bvenneker/Chat64/ZXSpectrum/KiCAD/voltage regulator.jpg

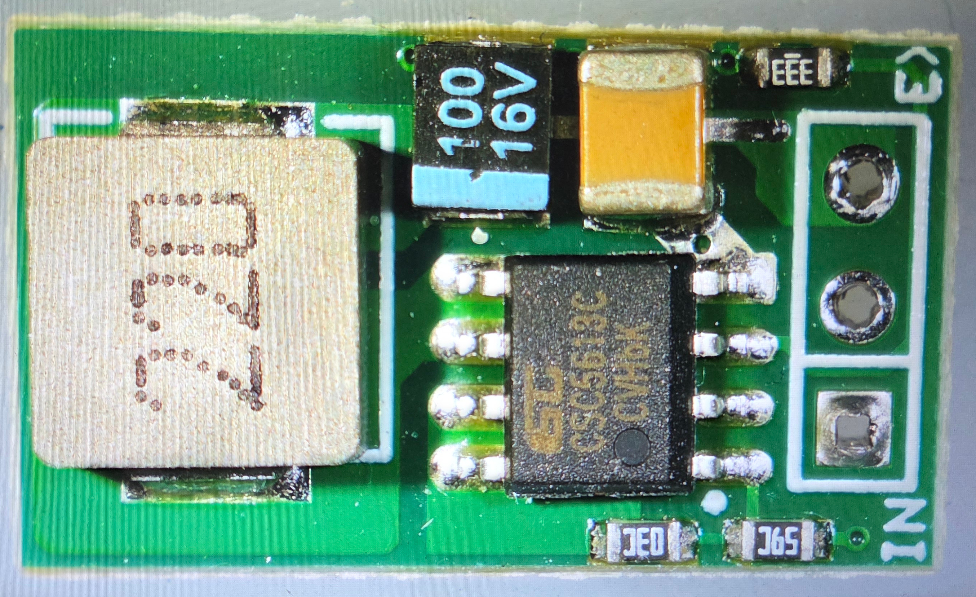
ZXSpectrum/KiCAD/voltage regulator.jpg
