bvenneker/Chat64/README.md

# CHAT64_C64
Chat64 for Commodore64, Sinclair ZX Spectrum, Atari 800XL, MSX and Amstrad CPC.
