bvenneker/Chat64/AmstradCPC/cartridge_model/readme.txt

I print the cartridge shells in PLA. I print the reset button in transparant PETG

extra hardware for the cartridge enclosure.

4 x m2 threaded inserts
4 x m2 screws (about 16 mm)
