bvenneker/Chat64/Atari800XL/cartridge_model/readme.txt

I print the cartridge shells in PLA. I print the reset button in transparant PETG

extra hardware for the cartridge enclosure.

1 x m3 threaded inserts
1 x m3 screw (16 mm)
