bvenneker/Chat64/MSX/cartridge_model/readme.txt

I print the cartridge shells in PLA. I print the reset button in transparant PETG

extra hardware for the cartridge enclosure.

3 x m2 threaded inserts
3 x m2 screws (about 16 mm)
