bvenneker/Chat64/ZXSpectrum/KiCAD/Readme.txt

Only the old THT version contains a GAL chip.
The old THT version DOES NOT WORK on a spectrum 128 +2b (the black one) and higher

The newer SMD version does not contain a GAL chip.
The SMD version works on the Spectrum 48k and better, including the +2b and up, made by Amstrad

Voltage regulator:
The pcb contains a 5v voltage regulator module (I get them from Aliexpress), see pictures
The ones I buy on Aliexpress have 3 pin connector on them, I remove that.
TIP: TEST the regulator before you install it. They should have about 5 volts (4.8 - 5.2) on the output but I have seen some that had the input voltage on the output.
