bvenneker/Chat64/ZXSpectrum/cartridge_model/Readme.txt

Version 1 THT (through hole technology)
The THT cartridge model needs:
3 x m2 Threaded Insert 
1 x m3 Threaded Insert 
3 x m2 screw (10mm)
1 x M3 screw (16mm)
