bvenneker/Chat64/ZXSpectrum/cartridge_model/labels.pdf

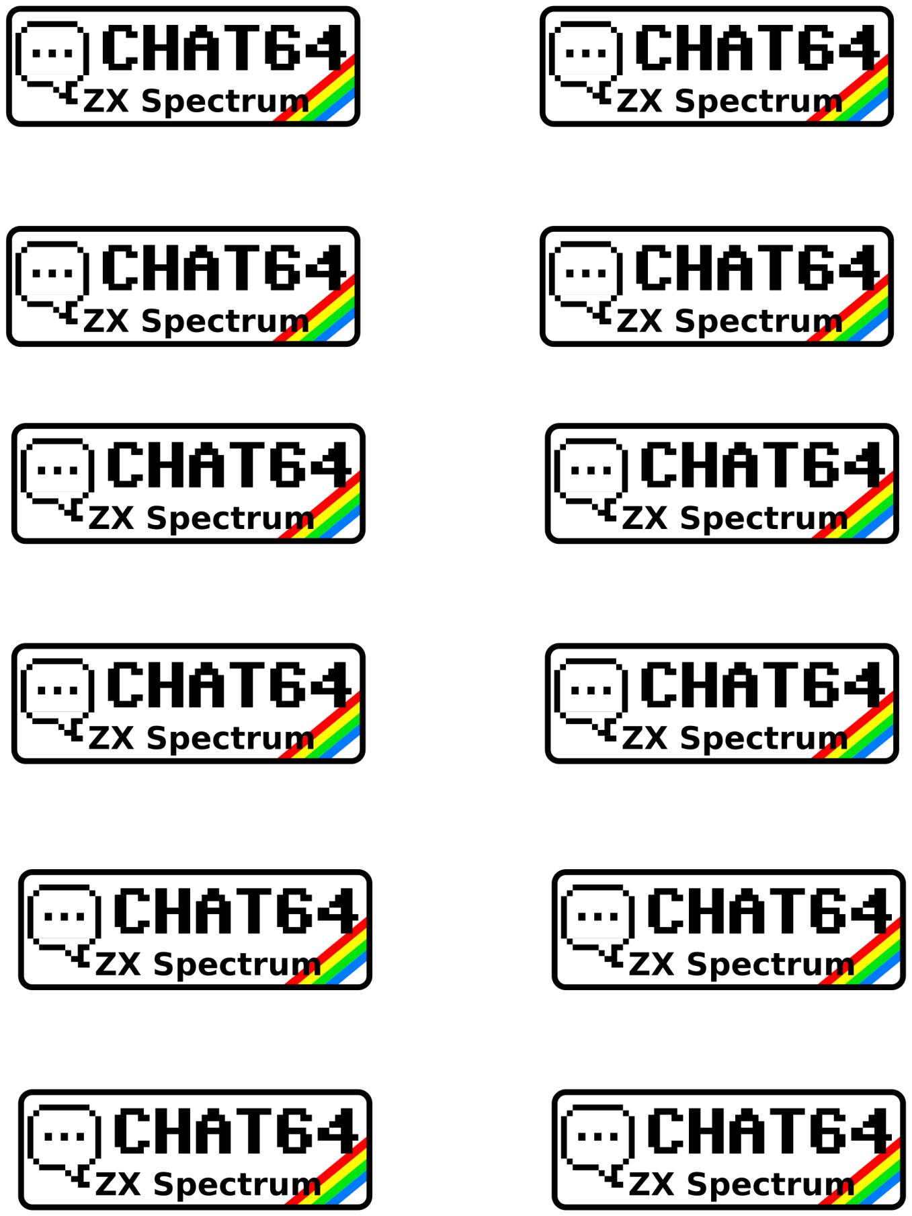
[picture p3: page 1]
