bvenneker/Chat64/AmstradCPC/cartridge_model/labels.pdf

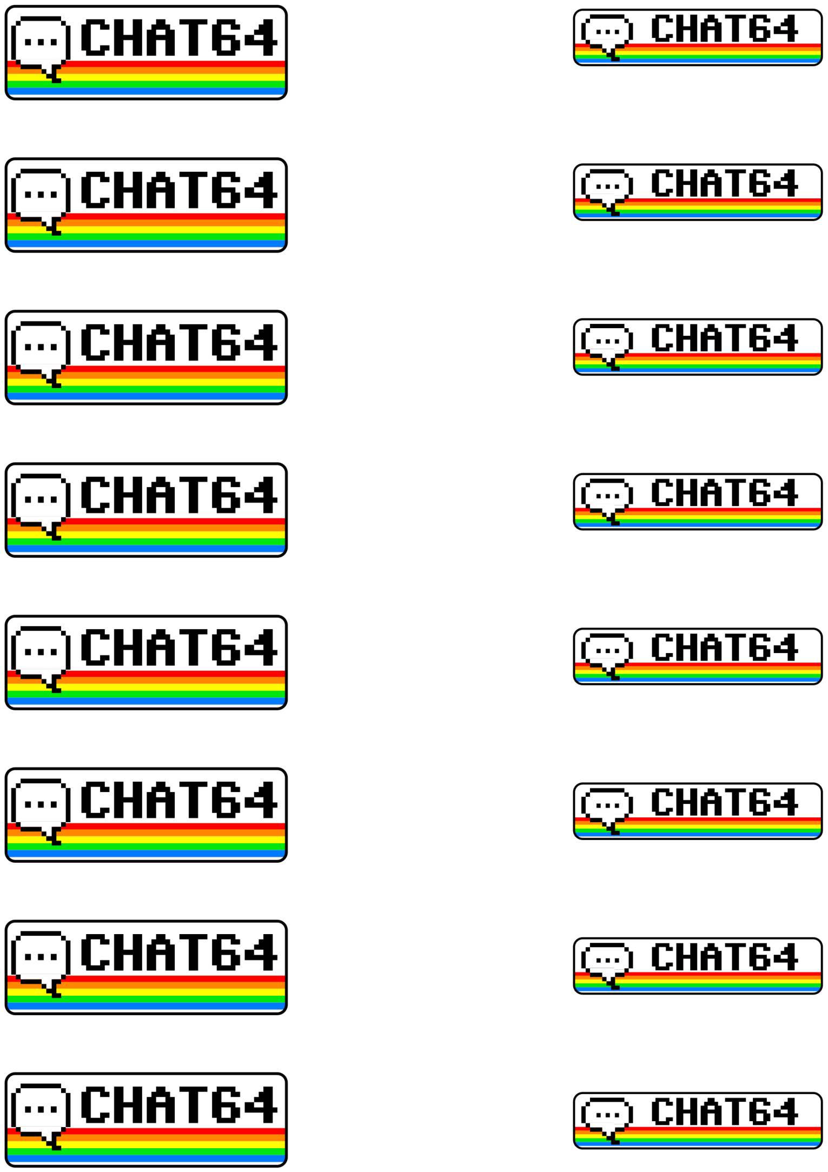
[picture p4: page 1]
