bvenneker/Chat64/AmstradCPC/cartridge_model/20260906_133205.jpg

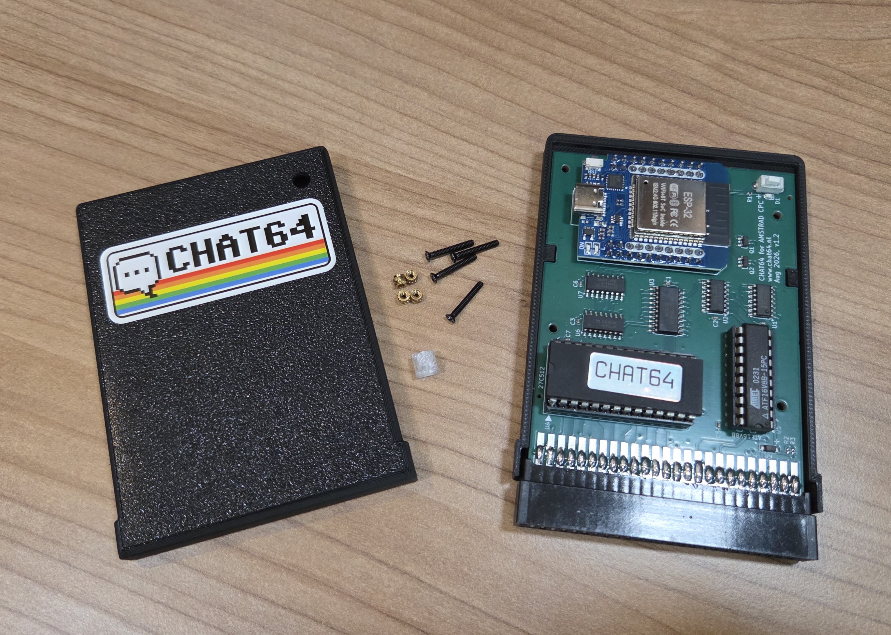
AmstradCPC/cartridge_model/20260906_133205.jpg
