bvenneker/Chat64/AmstradCPC/cartridge_model/20260906_134645.jpg

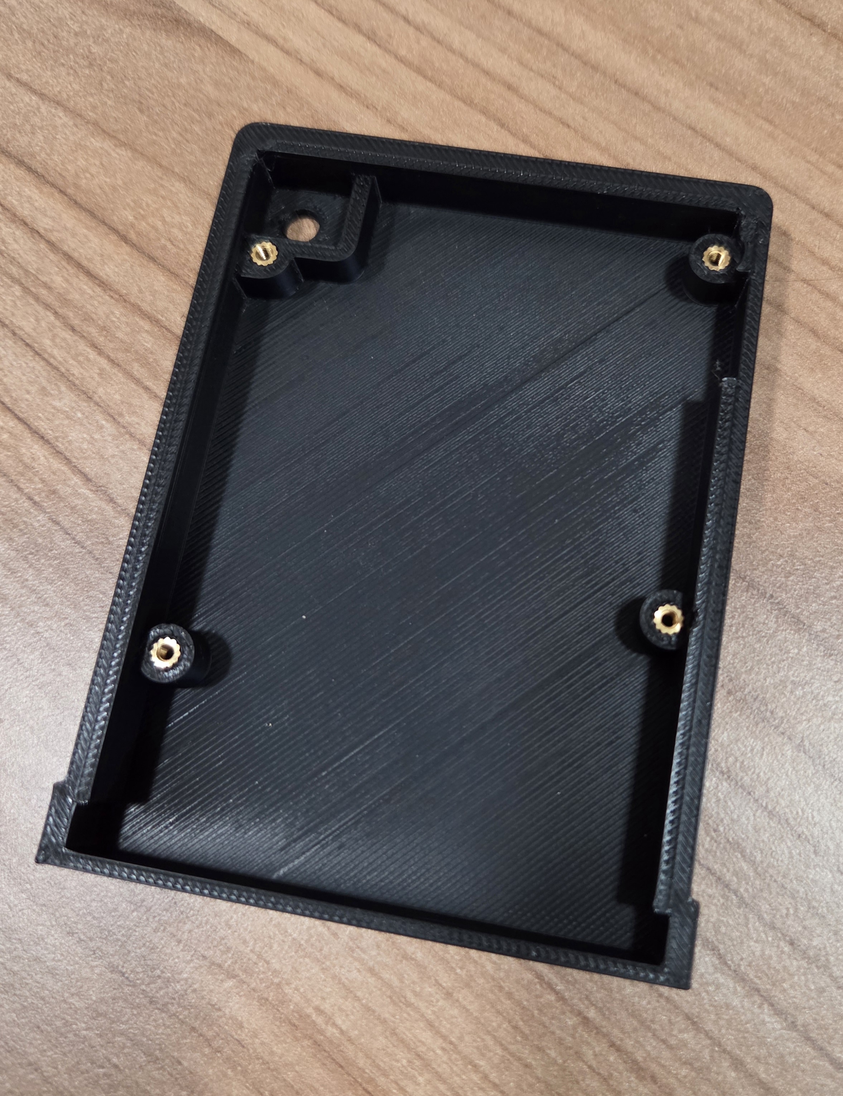
AmstradCPC/cartridge_model/20260906_134645.jpg
