bvenneker/Chat64/ZXSpectrum/cartridge_model/THT_20260906_115402.jpg

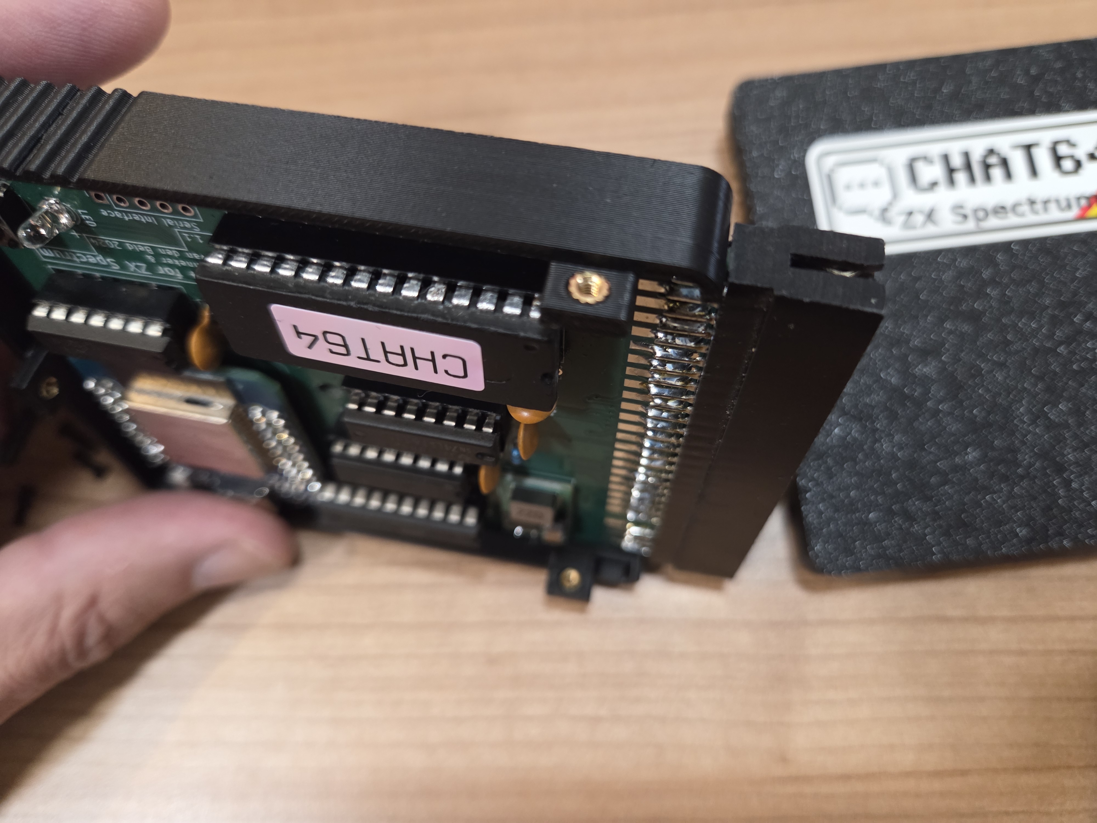
ZXSpectrum/cartridge_model/THT_20260906_115402.jpg
