bvenneker/Chat64/ZXSpectrum/KiCAD/voltage regulator_aliexpress.jpg

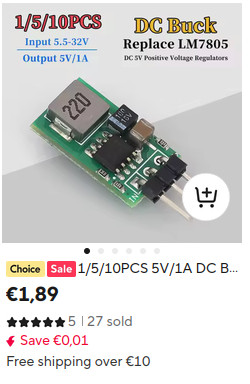
ZXSpectrum/KiCAD/voltage regulator_aliexpress.jpg
