bvenneker/Chat64/AmstradCPC/cartridge_model/CPC Cartridge Top Shell.stl

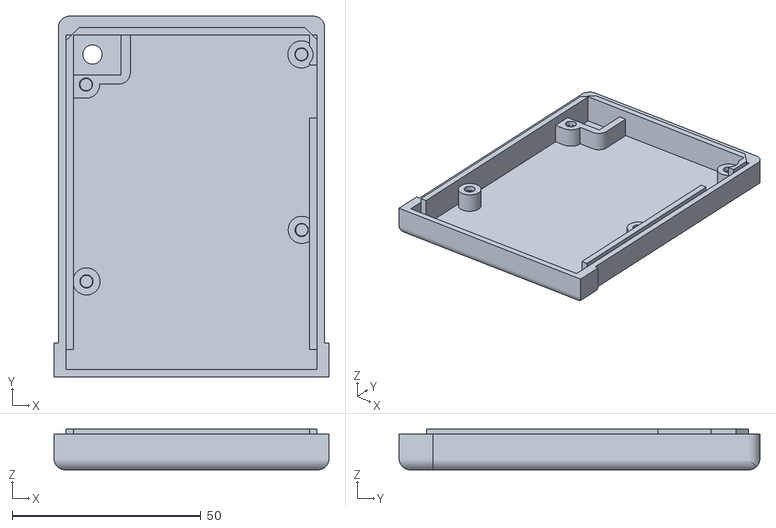
[picture p11: CAD file, 2026-09-07]
AmstradCPC/cartridge_model/CPC Cartridge Top Shell.stl
72.8 x 95.5 x 10.8
