bvenneker/Chat64/Atari800XL/cartridge_model/Atari_Chat_Cartridge_Button.stl

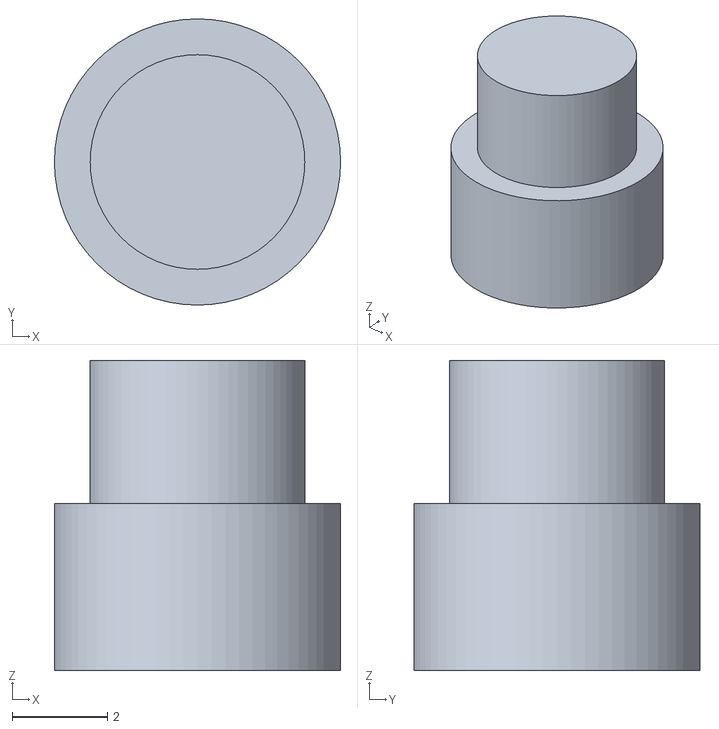
[picture p12: CAD file, 2026-09-07]
Atari800XL/cartridge_model/Atari_Chat_Cartridge_Button.stl
6.00 x 6.00 x 6.50
