bvenneker/Chat64/Commodore/cartridge_model/SMD Model/Chat64 SMD cartridge.3mf

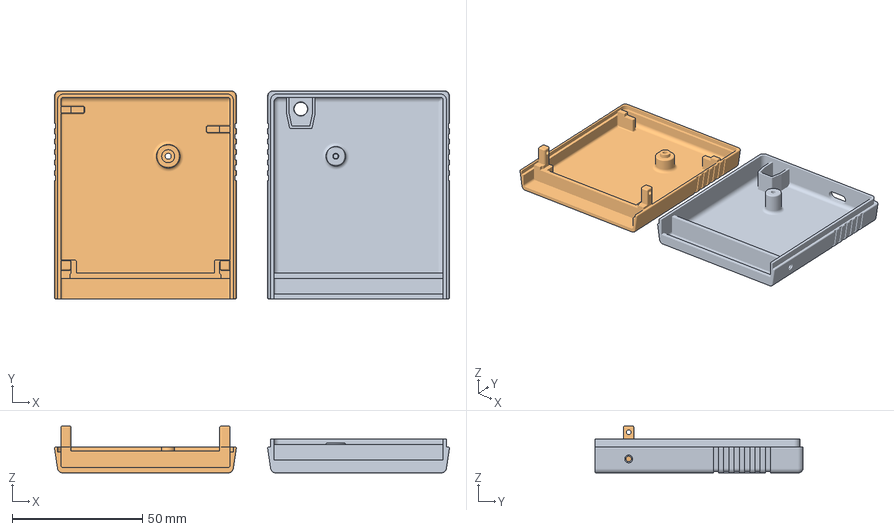
[picture p13: CAD file, 2026-09-05]
Commodore/cartridge_model/SMD Model/Chat64 SMD cartridge.3mf
151.7 x 80.0 x 18.0 mm
Upper
Lower
