bvenneker/Chat64/Commodore/cartridge_model/SMD Model/SMD-STL/Smd-lower.stl

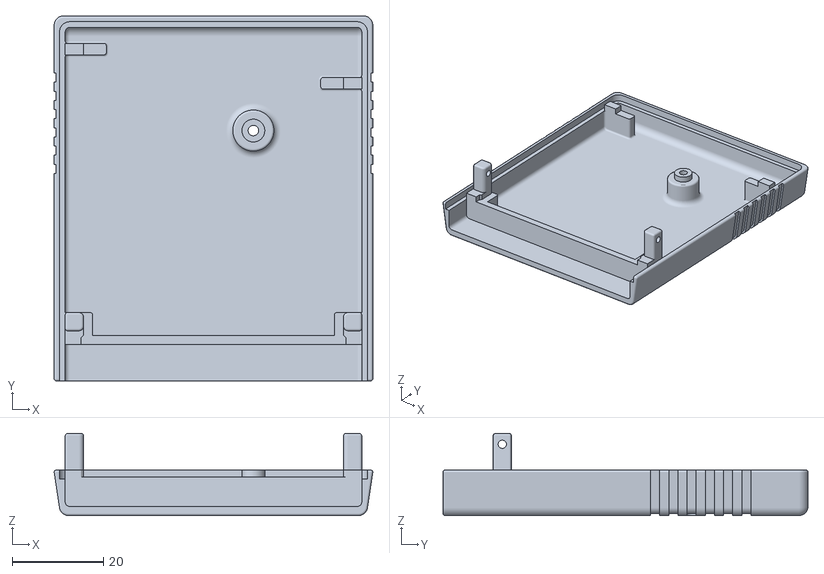
[picture p14: CAD file, 2026-09-05]
Commodore/cartridge_model/SMD Model/SMD-STL/Smd-lower.stl
69.8 x 80.0 x 18.0
