bvenneker/Chat64/Commodore/cartridge_model/THT Model/THT_model2025.stl

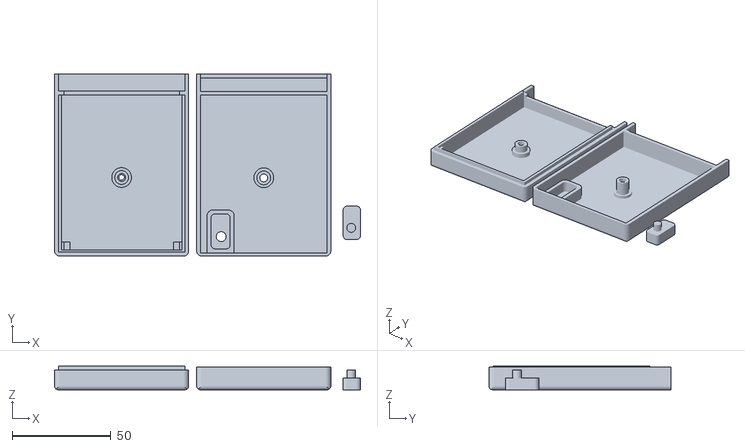
[picture p15: CAD file, 2026-09-05]
Commodore/cartridge_model/THT Model/THT_model2025.stl
155.0 x 92.3 x 12.0
