bvenneker/Chat64/MSX/cartridge_model/MSX Cartridge_Top.stl

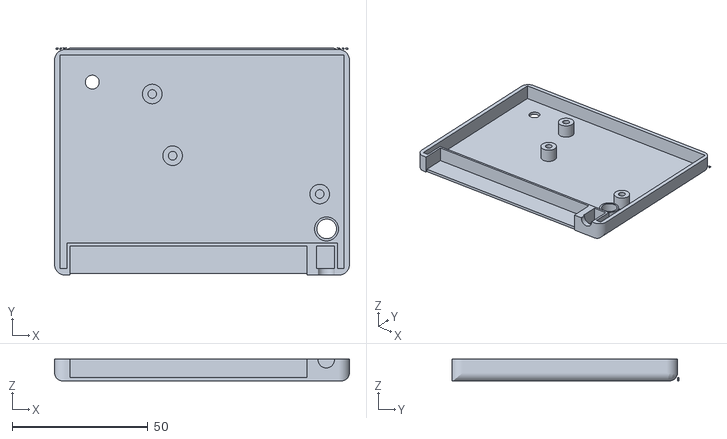
[picture p16: CAD file, 2026-09-07]
MSX/cartridge_model/MSX Cartridge_Top.stl
108.5 x 83.6 x 8.00
