bvenneker/Chat64/ZXSpectrum/cartridge_model/THT_Shell_Top.stl

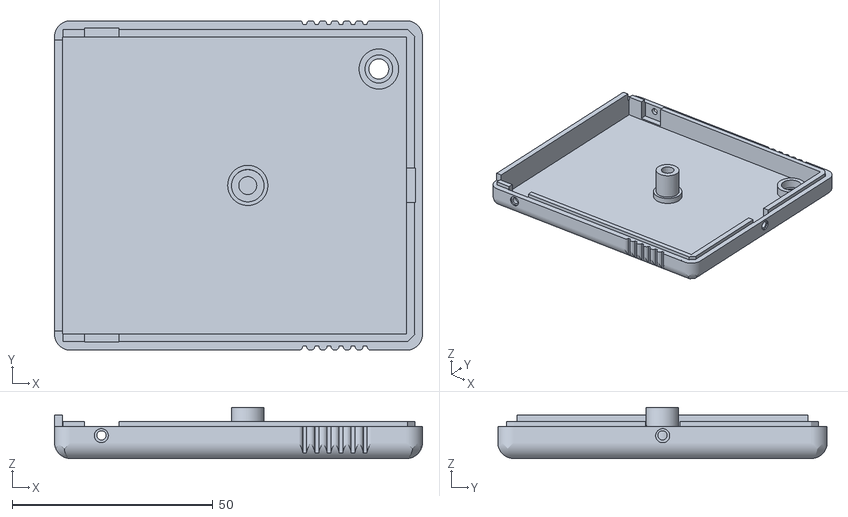
[picture p17: CAD file, 2026-09-06]
ZXSpectrum/cartridge_model/THT_Shell_Top.stl
91.6 x 82.0 x 12.7
