bvenneker/Chat64/AmstradCPC/cartridge_model/CPC Cartridge Bottom Shell.stl

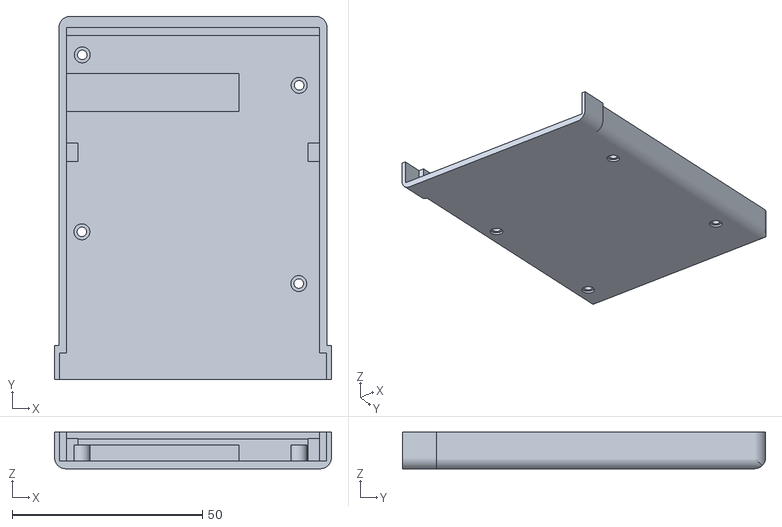
[picture p18: CAD file, 2026-09-07]
AmstradCPC/cartridge_model/CPC Cartridge Bottom Shell.stl
72.8 x 95.5 x 9.60
