bvenneker/Chat64/Atari800XL/cartridge_model/Atari_Chat_Cartridge_Top.stl

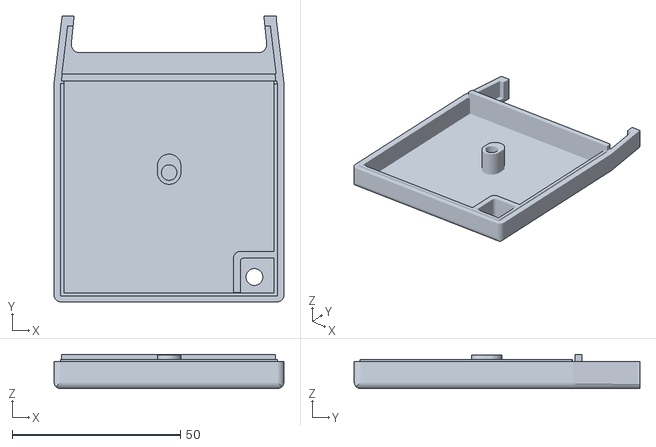
[picture p19: CAD file, 2026-09-07]
Atari800XL/cartridge_model/Atari_Chat_Cartridge_Top.stl
68.4 x 85.0 x 10.2
