bvenneker/Chat64/Commodore/cartridge_model/SMD Model/Cartridge knobs.3mf

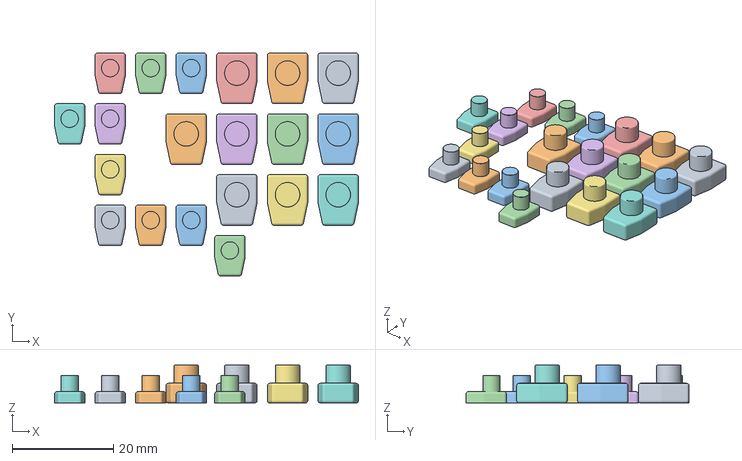
[picture p20: CAD file, 2026-09-05]
Commodore/cartridge_model/SMD Model/Cartridge knobs.3mf
60.0 x 44.0 x 7.50 mm
Knob x 10
Knob_hollow_trans_inner x 10
