bvenneker/Chat64/Commodore/cartridge_model/SMD Model/SMD-STL/Smd-knob_short.stl

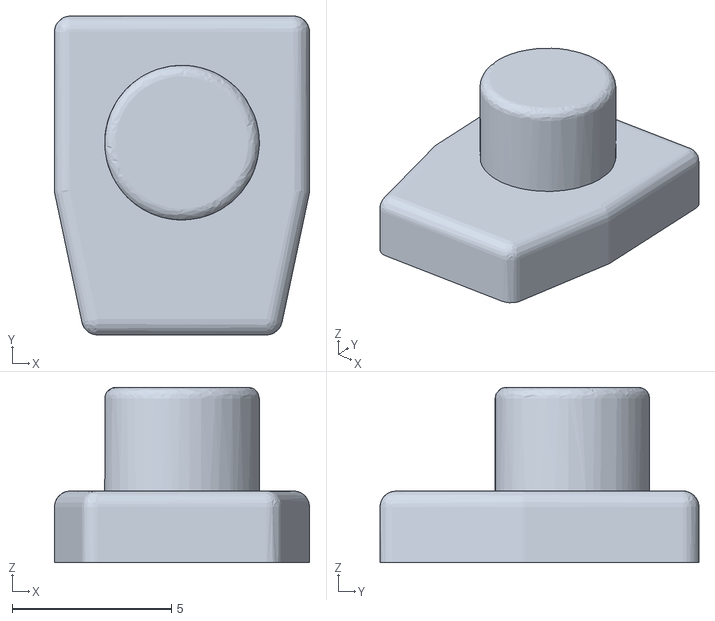
[picture p21: CAD file, 2026-09-05]
Commodore/cartridge_model/SMD Model/SMD-STL/Smd-knob_short.stl
8.00 x 10.0 x 5.50
