bvenneker/Chat64/MSX/cartridge_model/MSX Cartridge_Button.stl

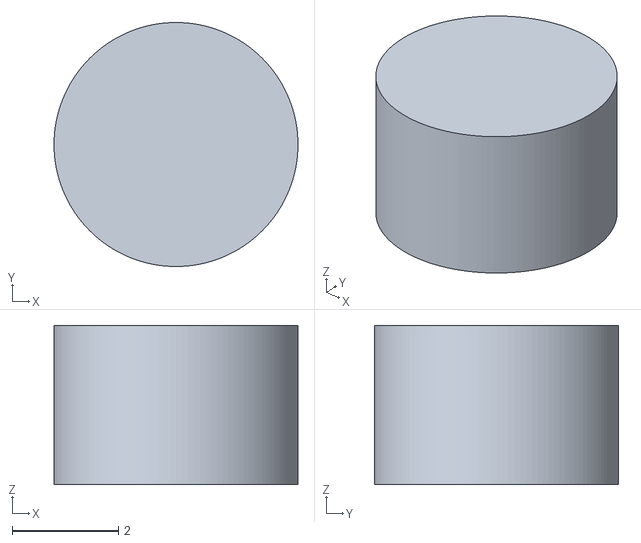
[picture p22: CAD file, 2026-09-07]
MSX/cartridge_model/MSX Cartridge_Button.stl
4.60 x 4.60 x 3.00
