bvenneker/Chat64/ZXSpectrum/cartridge_model/SMD_Shell_Bottom.stl

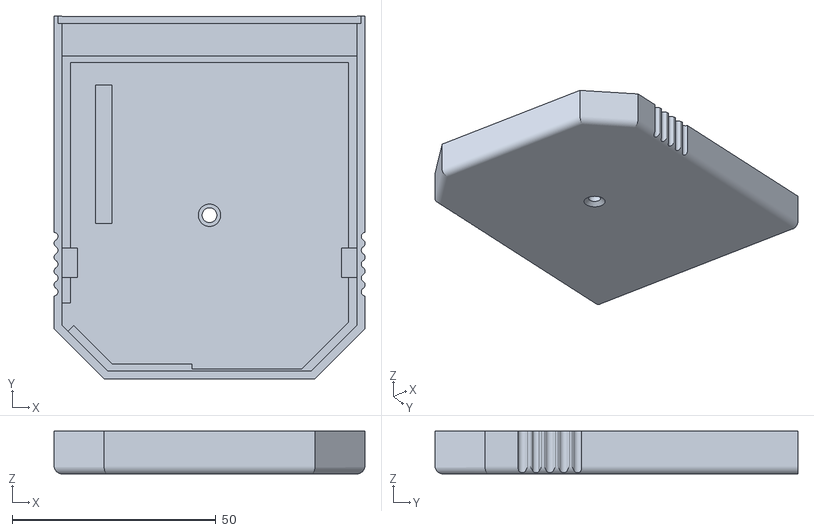
[picture p23: CAD file, 2026-09-06]
ZXSpectrum/cartridge_model/SMD_Shell_Bottom.stl
76.3 x 89.1 x 10.5
