bvenneker/Chat64/AmstradCPC/cartridge_model/CPC Cartridge Button.stl

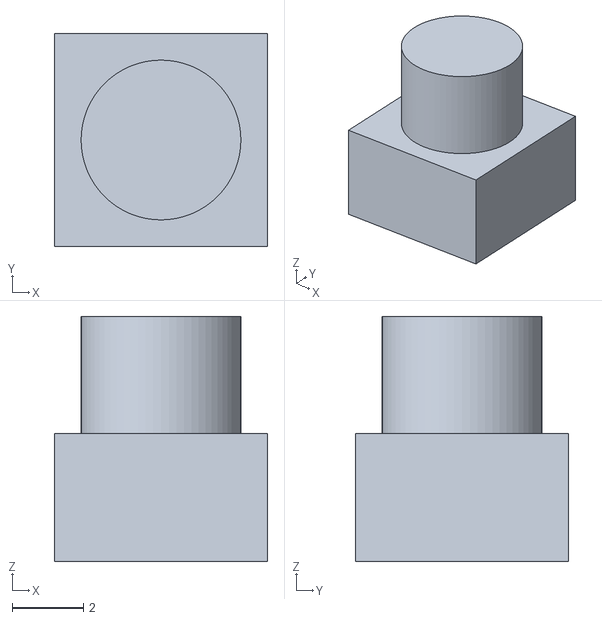
[picture p24: CAD file, 2026-09-07]
AmstradCPC/cartridge_model/CPC Cartridge Button.stl
6.00 x 6.00 x 6.90
