bvenneker/Chat64/Commodore/cartridge_model/SMD Model/SMD-STL/Smd-knob.stl

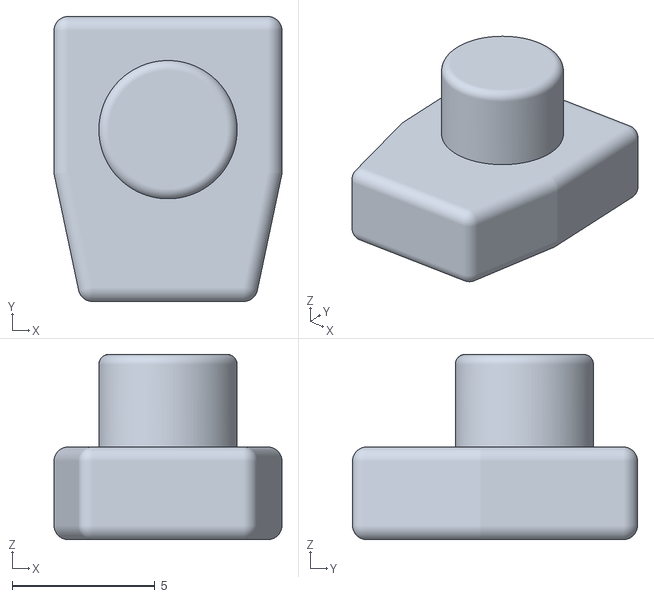
[picture p26: CAD file, 2026-09-05]
Commodore/cartridge_model/SMD Model/SMD-STL/Smd-knob.stl
8.00 x 10.0 x 6.50
