bvenneker/Chat64/MSX/cartridge_model/MSX Cartridge_Bottom.stl

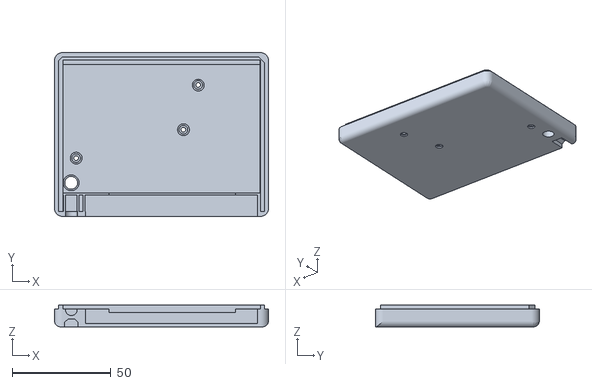
[picture p27: CAD file, 2026-09-07]
MSX/cartridge_model/MSX Cartridge_Bottom.stl
108.5 x 83.0 x 11.0
