bvenneker/Chat64/ZXSpectrum/cartridge_model/SMD_Shell_Top.stl

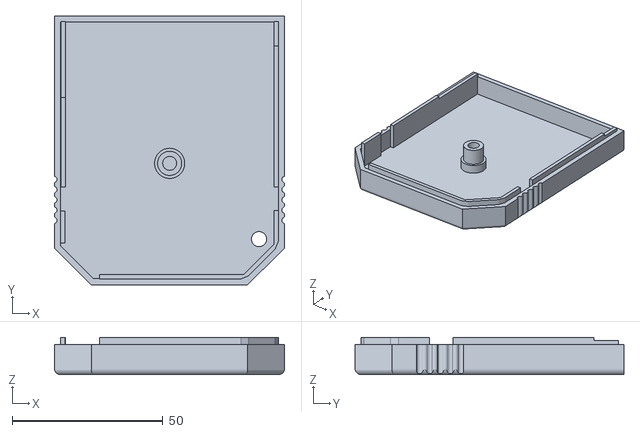
[picture p28: CAD file, 2026-09-06]
ZXSpectrum/cartridge_model/SMD_Shell_Top.stl
76.3 x 89.1 x 12.3
