bvenneker/Chat64/Commodore/cartridge_model/SMD Model/SMD-STL/Smd-upper.stl

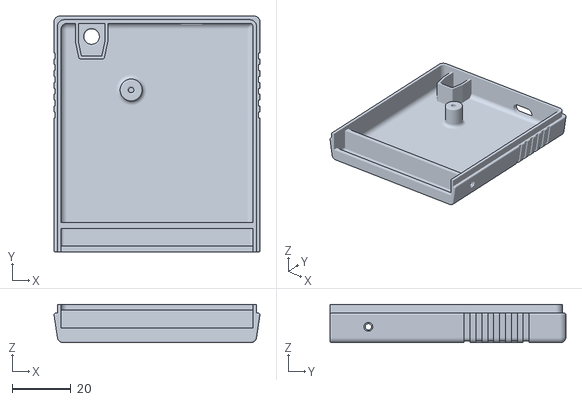
[picture p29: CAD file, 2026-09-05]
Commodore/cartridge_model/SMD Model/SMD-STL/Smd-upper.stl
69.8 x 80.0 x 13.0
