bvenneker/Chat64/ZXSpectrum/cartridge_model/SMD_Button.stl

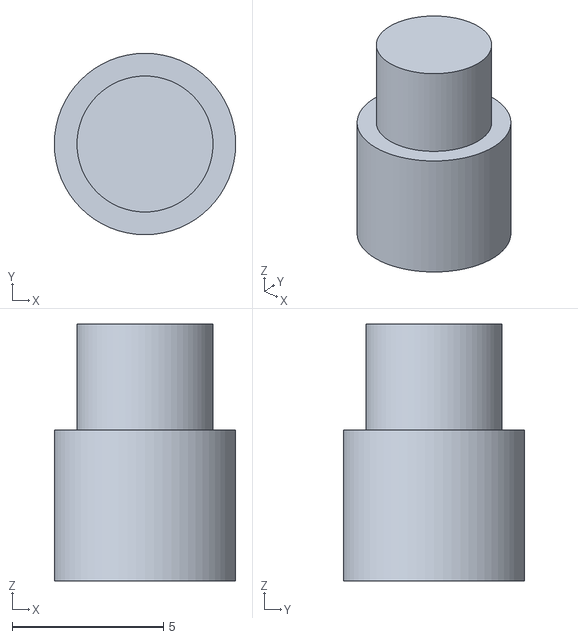
[picture p30: CAD file, 2026-09-06]
ZXSpectrum/cartridge_model/SMD_Button.stl
6.00 x 6.00 x 8.50
