bvenneker/Chat64/ZXSpectrum/cartridge_model/THT_Shell_Bottom.stl

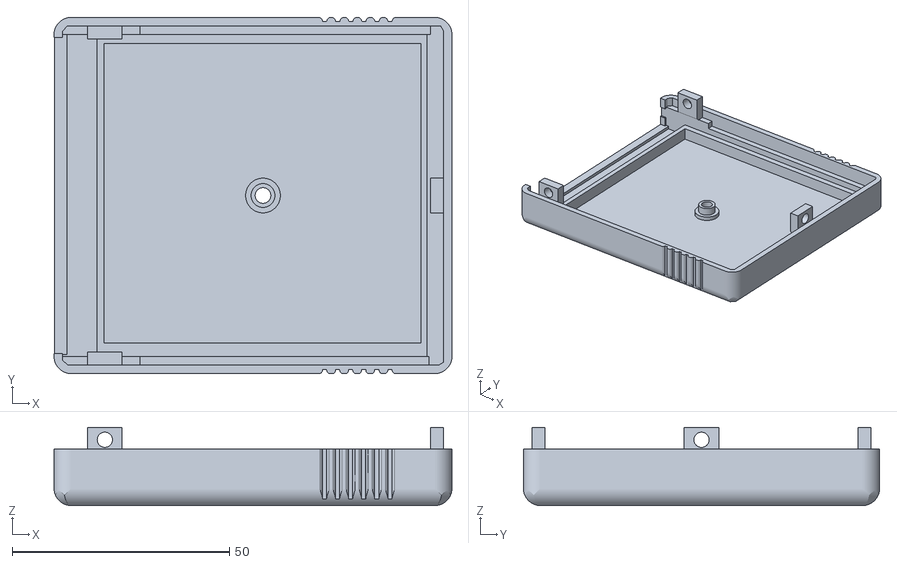
[picture p31: CAD file, 2026-09-06]
ZXSpectrum/cartridge_model/THT_Shell_Bottom.stl
91.6 x 82.0 x 18.0
