bvenneker/Chat64/ZXSpectrum/cartridge_model/THT_Button.stl

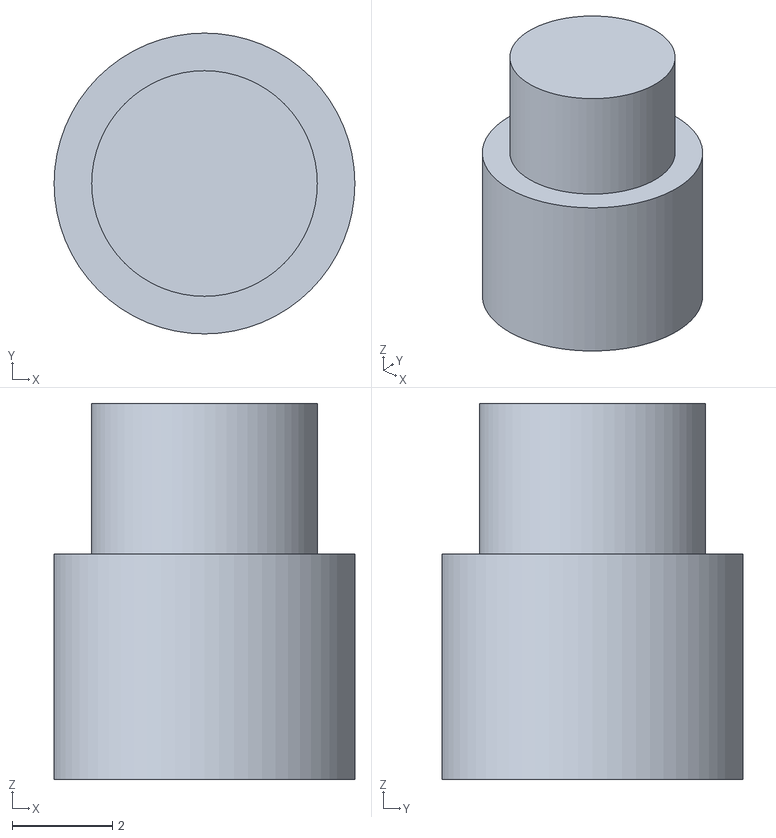
[picture p32: CAD file, 2026-09-06]
ZXSpectrum/cartridge_model/THT_Button.stl
6.00 x 6.00 x 7.50
