bvenneker/Chat64/ZXSpectrum/cartridge_model/Wedge.stl

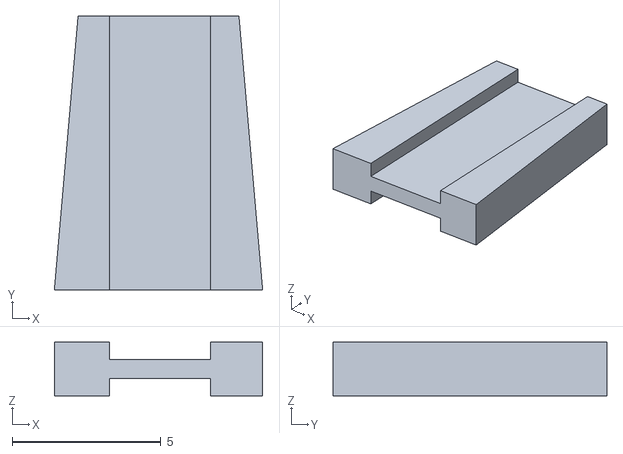
[picture p33: CAD file, 2026-09-06]
ZXSpectrum/cartridge_model/Wedge.stl
7.00 x 9.20 x 1.80
