bvenneker/Chat64/(threads)

Thread 1 (2024-02-17):

Can't wait to order a Chat64 kit!!!

Paulie420, 2024-02-17:
Thru-Hole, of course. - let us know where we can go.....

SvenPook, 2024-02-22:
An issue has been found, making the cartridges incompatible with some Commodore 64 board revisions. We want to fix this first to make sure every cartridge will work fine with any revision mainboard. Please bear with us, a new revision will be available soon.

SvenPook, 2024-02-22:
see comment above

bvenneker, 2024-04-02:
See: https://www.etsy.com/shop/bartselektronica

Closed 2024-02-22.

Thread 2 (2024-02-25):

Are the old Gerbers usable?

vk5ln, 2024-02-25:
Looks like I did a JLCPCB order too soon. I sent off the Chat64 SMD gerbers to JLCPCB last week, I've just had an email to say my order is on it's way to me.

I now see that the files have been removed due to an issue? Will my PCBs be useless? I used the production Gerber files.

SvenPook, 2024-02-25:
My old cartridge is still working, so that shouldn't be an issue.
Chances are that your cartridge might be incompatible with your Commodore 64's mainboard revision.

vk5ln, 2024-02-25:
Thank you for the reply.

bvenneker, 2024-02-25:
No, please wait a few days for the new design. We will upload them to
github when we have received the proto PCBs and tested them.

Best,
Bart

Op zo 25 feb. 2024 20:57 schreef vk5ln ***@***.***>:

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

vk5ln, 2024-02-26:
Too late :-) already have blank Chat64 SMD PCBs on the way. Oh well, they can join my pile of unused boards :-D

Crouze, 2024-02-26:
I understand the frustration of finding an error on your board design after going public with it, and having to re-design and re-test. However, a little bit more openness would be appreciated. I too already have PCB's on their way of the retracted THT design. Not a big investment, but still. The questions I now have are simple:

 - which C64 mainboard revisions were found to be incompatible with your PCB design? Which are known to work?
 - can the retracted PCB be modified (with cut traces and bodge wires) to the new design, at least in theory?

 Thanks.

bvenneker, 2024-02-27:
There is no error in the 'old' design. It works good on many C64s. Especially the newer C64-C. You may run into issues on older models. Then again, I think we have tested successfully on every revision including some very early ones.
It also works great on the Ultimate 64 model. But forget about the C64 sx :-)

We expect the prototype pcb's at the end of this week, we will publish the new design as soon as we have tested them.

Crouze, 2024-02-27:
Good to hear. Then I will populate my PCB which should also arrive at the end of this week (I hope) and assume it will work on my '64. Thanks for your reply.

Crouze, 2024-02-29:
Well, I am having problems nevertheless.

Received the THT PCB's yesterday (Rev 2.8 it says) and soldered one of them up. Soldering went good, no issues there (not a novice here). The only point might be that the resistor hole spacing is too narrow for regular 6mm resistors despite there being more than enough space on the board. But that is not the problem.

As part of my troubleshooting I re-flashed both the ESP32 and the EEPROM, no change.

All chips were tested OK with the Retro Chip Tester.

Tested the cartridge on both of my C64's: an original and unmodified 250425, and a SixtyClone 250466. Both show the same behaviour.

The cartridge is unusable to work with because it constantly resets whenever settings are typed in (WiFi settings, Server settings). If left alone after boot it will show the start screen well. The function keys work well. But after the first character is entered on a settings screen the board will reset exactly 5 seconds after that.

The ESP32 board has a constant RED led, and a blue LED between resets.

Another thing I see is that the LED next to the reset switch on the board does not light up under any circumstance. The LED itself is good (and correctly soldered).

Maybe the developers can shed some light on this? My suspicion lies with the ESP32 board, but since it is still not clear what the issues were for the developers to retract the Gerber files (hardware, or software issue?) it is hard to guess.

I will probably put this little project aside for the time being, it is costing me more frustration than hoped for. Maybe I'll try again if it is a little bit more mature.

Crouze, 2024-03-01:
Adding to my previous post, going through the ESP32 sketch I noticed that the blue LED turns on when there is actually a WiFi connection. I did manage to enter my SSID and password after many attempts, but the screens still say "WiFi not connected" yet the LED turns on. Also on the settings screen the entries are repeated at the next viewing of the screen, so for instance the SSID (lets say it is "MyWiFi") then shows as "MyWifiMyWifi", or with some random characters. Letting me believe that the EEPROM is not properly read/written.

I have changed out the ESP32, no change. Last thing I will do is to change the AT28C64B EEPROM with a spare.

vk5ln, 2024-03-11:
As a final comment on this. If the SMD board is being re-worked, can I suggest a move to slightly larger SMD resistors and capacitors to help those hand soldering the boards?

0402 (1005 metric) components are a bit small to easily manipulate and hand solder. 0603 would be easy to accommodate on the PCB and would help hand soldering assemblers immensely.

bvenneker, 2024-04-02:
Kicad project (including gerbers) are now available in github

Closed 2024-04-02.

Thread 8 (2024-04-04):

issue with tht schematic

heneault, 2024-04-04:
I think there are some issues in the latest schematic of the THT version:

- 74hct125 should not be run at 3.3v. According to spec, vcc should be between 4.5 V to 5.5 V For HCT circuits operating at less than 4.5 V, the load-level noise margin is reduced and becomes incompatible with TTL thresholds.

- NMI line is open collector. if NMI if pulled on commodore side (i.e. pressing restore key) a short circuit will on pin 6 of U8 of the C64.

- there is no need to connect oNMI to 74hct125 as this is already 3v

- the 74hc597 has a min Vih of 3.15 v when vcc is at 4.5v.  Since you are running at 5v it is a little be higher and probably close to 3.3v . That could affect high logic detection of pload and sclk.

bvenneker, 2024-04-04:
Hi,
Thanks for your input again!

About the nmi line.
So if the restore key is pressed, U8 (in the C64) tries to pull that signal
low while the cartridge tries to hold it high. So we can fix that by also
using an open collector on our side, thus using an npn transistor without
going through the 74hc125, that would also fix your third remark. Agree??

Best,
Bart

Op do 4 apr 2024 om 03:01 schreef Yannick Heneault ***@***.***
>:

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

heneault, 2024-04-06:
yes that would fix it. But I think you must also add a resistance between the collector and the cartridge pin as the voltage of the collector at saturation is near 0v (but not 0v). The resistance will limit the current that will sink on the line. Make sure the current is limited to what the ttl chip in the c64 can handle.

Otherwise, you can use something like a 74ls06

Thread 14 (2024-05-15):

What has changed between THT Rev.3.7 and Rev.3.8?

vk5ln, 2024-05-15:
I have just received some THT Rev.3.7 boards from my PCB vendor and I see that there is a new revision 3.8.
What was updated? Could a changelog be added to detail what has been updated/changed with each revision.
If I populate a Rev.3.7 PCB will Chat64 work OK?

bvenneker, 2024-05-15:
The change is minor. We decided to trigger both reset and  the NMI signal with a transistor in rev 3.8.
In revision 3.7 we used a transistor to trigger the reset signal and a logic port to trigger NMI. In 3.8 both use a transistor.
Yes, it will work just fine. I also still use revision 3.7 for development.

vk5ln, 2024-05-15:
Thanks for the information. After I posted I did compare the two schematics and did notice the extra transistor.
Consider this issue closed :-)

Thread 15 (2024-05-22):

SSID names with spacebars not working

dimian123, 2024-05-22:
I have trouble connecting to wifi. I have spacebars in my SSID name (for example "ASUS Wifi").
When I type in on the C64 it gives me error and the SSID name only displays the first word.
It works when I connect to my mobile hotspot SSID named "test".

bvenneker, 2024-05-22:
Hi, Yes that is a known limitation at the moment. We will change that in the future?

for my information: What version number do you see at the bottom of the main menu?

dimian123, 2024-05-23:
Version is ROM 3.64 ESP 3.68 04/2024

bvenneker, 2024-05-23:
I will fix that issue with spaces in the SSID name this weekend.
Do you have experience with the Arduino IDE?  are you able to upload new firmware to the ESP32?

dimian123, 2024-05-23:
Ok, cool!
Yes I have everything setup and ready.

bvenneker, 2024-05-25:
Okay,
You will need to download this zip file
https://github.com/bvenneker/Chat64/blob/Boot-Loader/ESP32%20Sketch/C64_Chat_3_71.zip
and follow the steps in this readme
https://github.com/bvenneker/Chat64/blob/Boot-Loader/ESP32%20Sketch/C64_Chat_3_71/readme.md

dimian123, 2024-05-25:
working!

bvenneker, 2024-05-25:
Nice, Closing issue

Closed 2024-05-25.

Thread 16 (2024-06-22):

Can support be added for half hour time zones?

vk5ln, 2024-06-22:
I am (un)lucky enough to live in an area of the world were we have a half hour time zone, South Australia. Standard time is 9.5 hours ahead of UTC and Summer time is 10.5 hours. While the Chat64 software does allow entering +9.5 for the Time Offset, this doesn't give me the correct time.

I know this is a narrow edge case issue but I am hoping that this could be addressed at some stage.

During the summer Australia's standard three time zones grows to five as some states do not observe daylight saving time. We even end up with the crazy situation where a state to the East of South Australia (Queensland) is 30 minutes behind us!

bvenneker, 2024-06-24:
Hi, I can fix that!
The time offset is added (or substracted) in the php code on the server so we might get lucky and do not need to change the cartridge code.. I'll be back.
Bart

bvenneker, 2024-06-24:
That has been fixed now. You should get the correct time now.
I changed it in the backend so no need to update your cartridge.

vk5ln, 2024-06-25:
Thank you so much for checking this out. I will try it out and see how it goes.

vk5ln, 2024-06-26:
I've sent a few test messages this morning (my time) and the time that appears next to the message is still 30 mins out. If I send the message at 1.10pm, it appears as 12.40pm on the software. I have set Time Offset at +9.5. Do I need to specify minutes eg +9.30 ?

bvenneker, 2024-06-26:
+9.5 should be the right format.
I see what I did.. It should be working now. Please let me know.
