bvenneker/Chat64/AmstradCPC/KiCAD/cpc_Chat64_v1.1/cpc_Chat64_v1.1.kicad_pcb

## KiCad design AmstradCPC/KiCAD/cpc_Chat64_v1.1/cpc_Chat64_v1.1.kicad_pcb (2026-09-07)

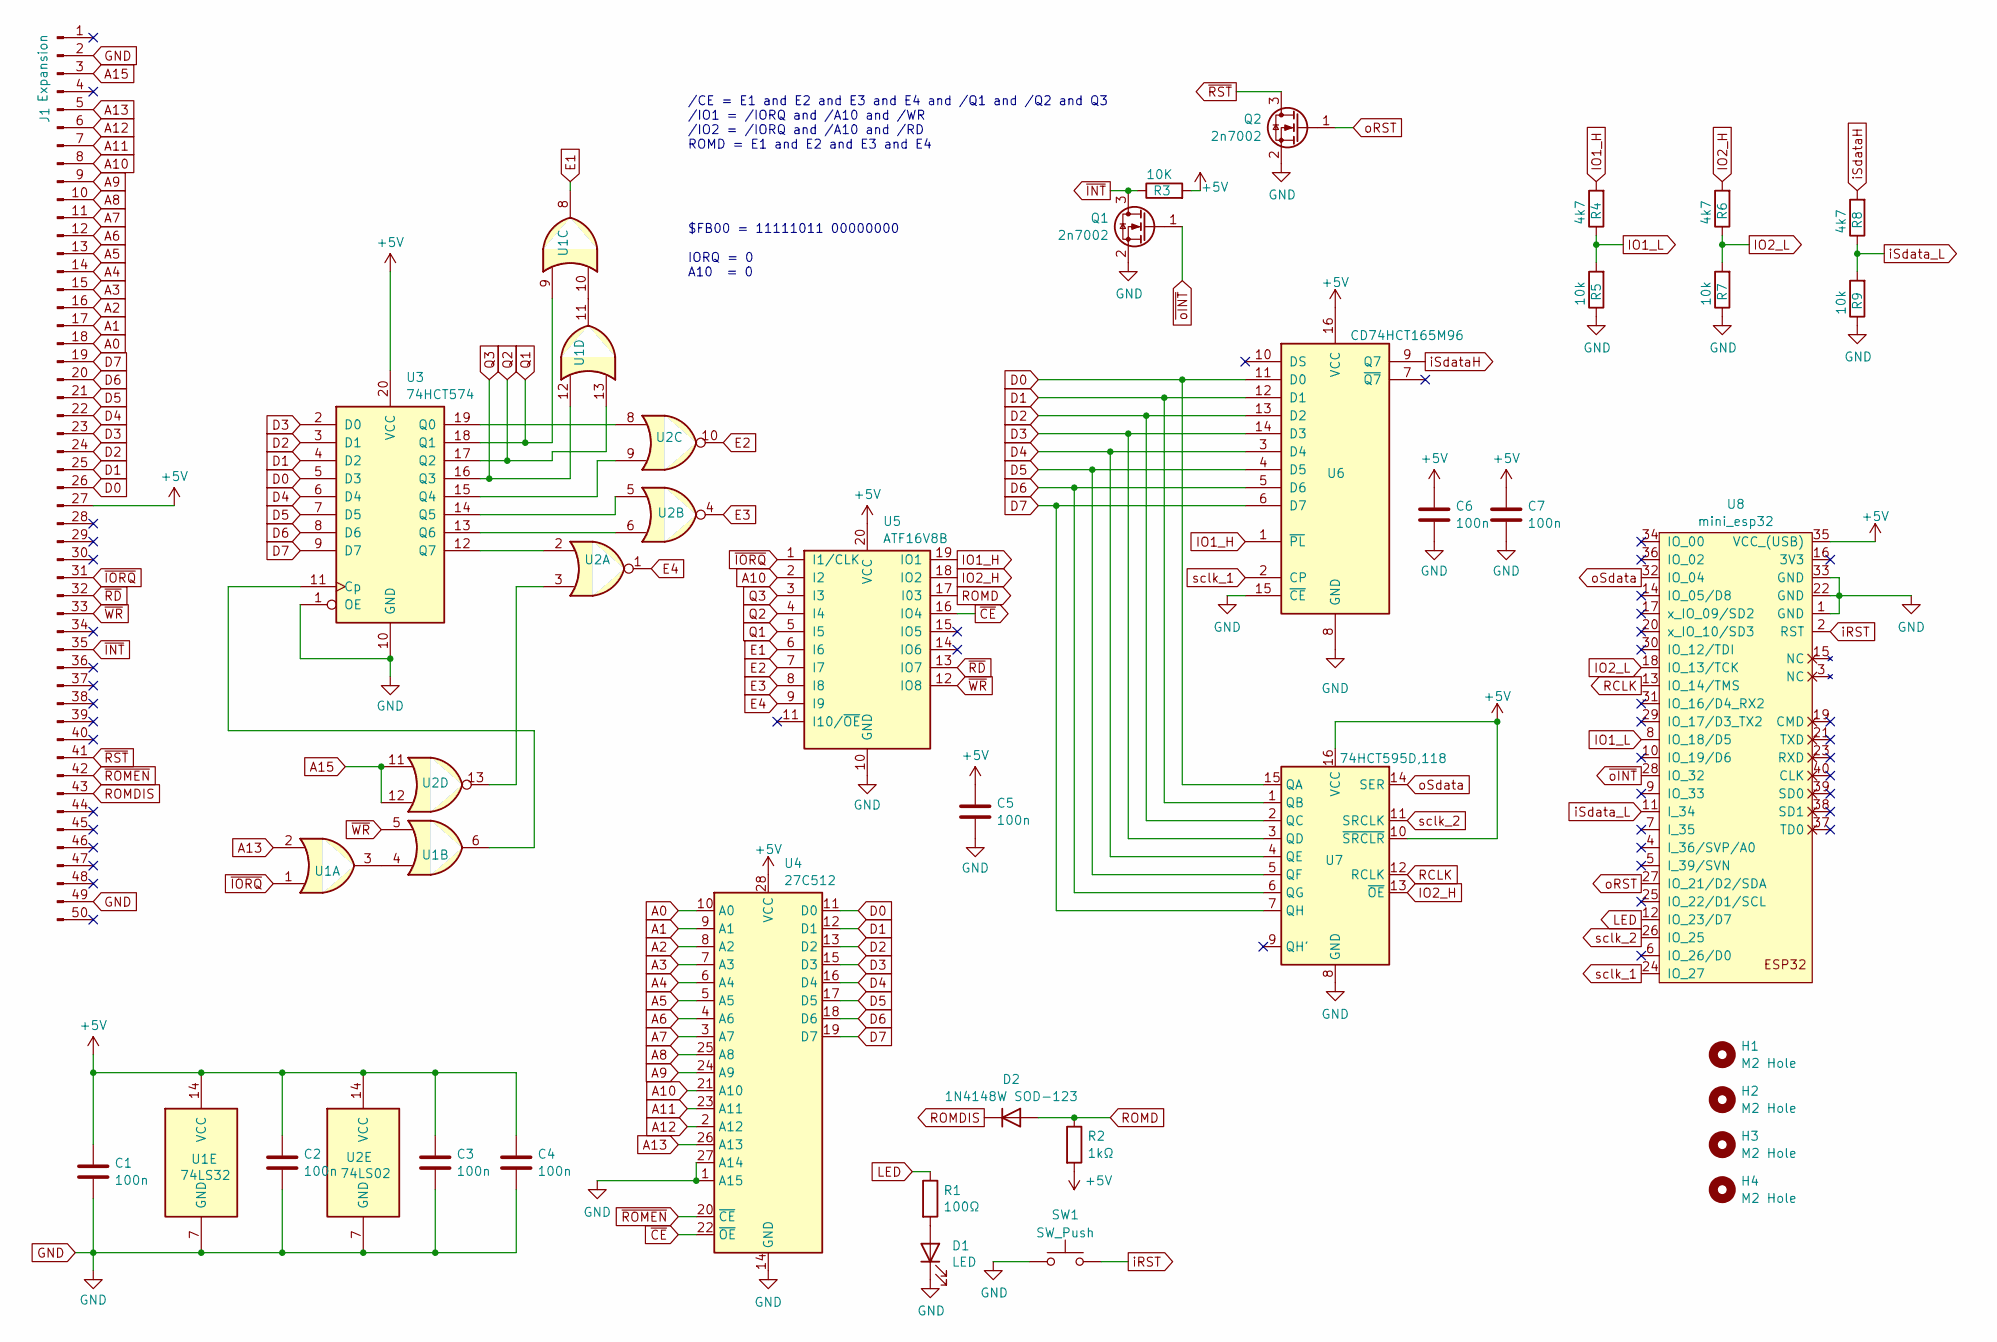
[picture p34: schematic cpc_Chat64_v1.1.kicad_sch]

Parts:
C1, C2, C3, C4, C5, C6, C7: 100n; C_0402_1005Metric
D1: LED; LED_0603_1608Metric
D2: 1N4148W SOD-123; D_SOD-123
H1, H2, H3, H4: M2 Hole; MountingHole_2.2mm_M2
J1: Expansion; cpc464_Expansion
Q1, Q2: 2n7002; SOT-23
R1: 100Ω; R_0402_1005Metric
R2: 1kΩ; R_0402_1005Metric
R3: 10K; R_0402_1005Metric
R4, R6, R8: 4k7; R_0402_1005Metric
R5, R7, R9: 10k; R_0402_1005Metric
SW1: SW_Push; SW_PUSH_HALF_6mm
U1: 74LS32; SO-14_3.9x8.65mm_P1.27mm
U2: 74LS02; SO-14_3.9x8.65mm_P1.27mm
U3: 74HCT574; SO-20_5.3x12.6mm_P1.27mm
U4: 27C512; DIP-28_W15.24mm_Socket_LongPads
U5: ATF16V8B; DIP-20_W7.62mm_LongPads
U6: CD74HCT165M96; SOIC-16_3.9x9.9mm_P1.27mm
U7: 74HCT595D,118; SOIC-16_3.9x9.9mm_P1.27mm
U8: mini_esp32; ESP32_mini

Connections:
+5V: C1.1, C2.1, C3.1, C4.1, C5.1, C6.1, C7.1, J1.27, R2.2, R3.2, U1.14 (VCC), U2.14 (VCC), U3.20 (VCC), U4.28 (VCC), U5.20 (VCC), U6.16 (VCC), U7.10 (~SRCLR), U7.16 (VCC), U8.35 (VCC_(USB))
A0: J1.18, U4.10 (A0)
A1: J1.17, U4.9 (A1)
A2: J1.16, U4.8 (A2)
A3: J1.15, U4.7 (A3)
A4: J1.14, U4.6 (A4)
A5: J1.13, U4.5 (A5)
A6: J1.12, U4.4 (A6)
A7: J1.11, U4.3 (A7)
A8: J1.10, U4.25 (A8)
A9: J1.9, U4.24 (A9)
A10: J1.8, U4.21 (A10), U5.2 (I2)
A11: J1.7, U4.23 (A11)
A12: J1.6, U4.2 (A12)
A13: J1.5, U1.2, U4.26 (A13)
A15: J1.3, U2.11, U2.12
D0: J1.26, U3.5 (D3), U4.11 (D0), U6.11 (D0), U7.15 (QA)
D1: J1.25, U3.4 (D2), U4.12 (D1), U6.12 (D1), U7.1 (QB)
D2: J1.24, U3.3 (D1), U4.13 (D2), U6.13 (D2), U7.2 (QC)
D3: J1.23, U3.2 (D0), U4.15 (D3), U6.14 (D3), U7.3 (QD)
D4: J1.22, U3.6 (D4), U4.16 (D4), U6.3 (D4), U7.4 (QE)
D5: J1.21, U3.7 (D5), U4.17 (D5), U6.4 (D5), U7.5 (QF)
D6: J1.20, U3.8 (D6), U4.18 (D6), U6.5 (D6), U7.6 (QG)
D7: J1.19, U3.9 (D7), U4.19 (D7), U6.6 (D7), U7.7 (QH)
E1: U1.8, U5.6 (I6)
E2: U2.10, U5.7 (I7)
E3: U2.4, U5.8 (I8)
E4: U2.1, U5.9 (I9)
GND: C1.2, C2.2, C3.2, C4.2, C5.2, C6.2, C7.2, D1.1 (K), J1.2, J1.49, Q1.2 (S), Q2.2 (S), R5.1, R7.1, R9.1, SW1.1, U1.7 (GND), U2.7 (GND), U3.1 (OE), U3.10 (GND), U4.1 (A15), U4.14 (GND), U4.27 (A14), U5.10 (GND), U6.8 (GND), U6.15 (~CE), U7.8 (GND), U8.1 (GND), U8.22 (GND), U8.33 (GND)
IO1_H: R4.2, U5.19 (IO1), U6.1 (~PL)
IO1_L: R4.1, R5.2, U8.8 (IO_18/D5)
IO2_H: R6.2, U5.18 (IO2), U7.13 (~OE)
IO2_L: R6.1, R7.2, U8.18 (IO_13/TCK)
LED: R1.1, U8.12 (IO_23/D7)
unnamed: D1.2 (A), R1.2
unnamed: U1.3, U1.4
unnamed: U1.10, U1.11
unnamed: U2.3, U2.13
unnamed: U1.6, U3.11 (Cp)
unnamed: U2.8, U3.19 (Q0)
unnamed: U2.9, U3.15 (Q4)
unnamed: U2.5, U3.14 (Q5)
unnamed: U2.6, U3.13 (Q6)
unnamed: U2.2, U3.12 (Q7)
Q1: U1.9, U3.18 (Q1), U5.5 (I5)
Q2: U1.13, U3.17 (Q2), U5.4 (I4)
Q3: U1.12, U3.16 (Q3), U5.3 (I3)
RCLK: U7.12 (RCLK), U8.13 (IO_14/TMS)
ROMD: D2.2 (A), R2.1, U5.17 (I03)
ROMDIS: D2.1 (K), J1.43
iRST: SW1.2, U8.2 (RST)
iSdataH: R8.2, U6.9 (Q7)
iSdata_L: R8.1, R9.2, U8.11 (I_34)
oRST: Q2.1 (G), U8.27 (IO_21/D2/SDA)
oSdata: U7.14 (SER), U8.32 (IO_04)
sclk_1: U6.2 (CP), U8.24 (IO_27)
sclk_2: U7.11 (SRCLK), U8.26 (IO_25)
~CE: U4.22 (~OE), U5.16 (IO4)
~INT: J1.35, Q1.3 (D), R3.1
~IORQ: J1.31, U1.1, U5.1 (I1/CLK)
~RD: J1.32, U5.13 (IO7)
~ROMEN: J1.42, U4.20 (~CE)
~RST: J1.41, Q2.3 (D)
~WR: J1.33, U1.5, U5.12 (IO8)
~oINT: Q1.1 (G), U8.28 (IO_32)

Notes on the sheet:
/CE = E1 and E2 and E3 and E4 and /Q1 and /Q2 and Q3 /IO1 = /IORQ and /A10 and /WR /IO2 = /IORQ and /A10 and /RD ROMD = E1 and E2 and E3 and E4
$FB00 = 11111011 00000000 IORQ = 0 A10 = 0

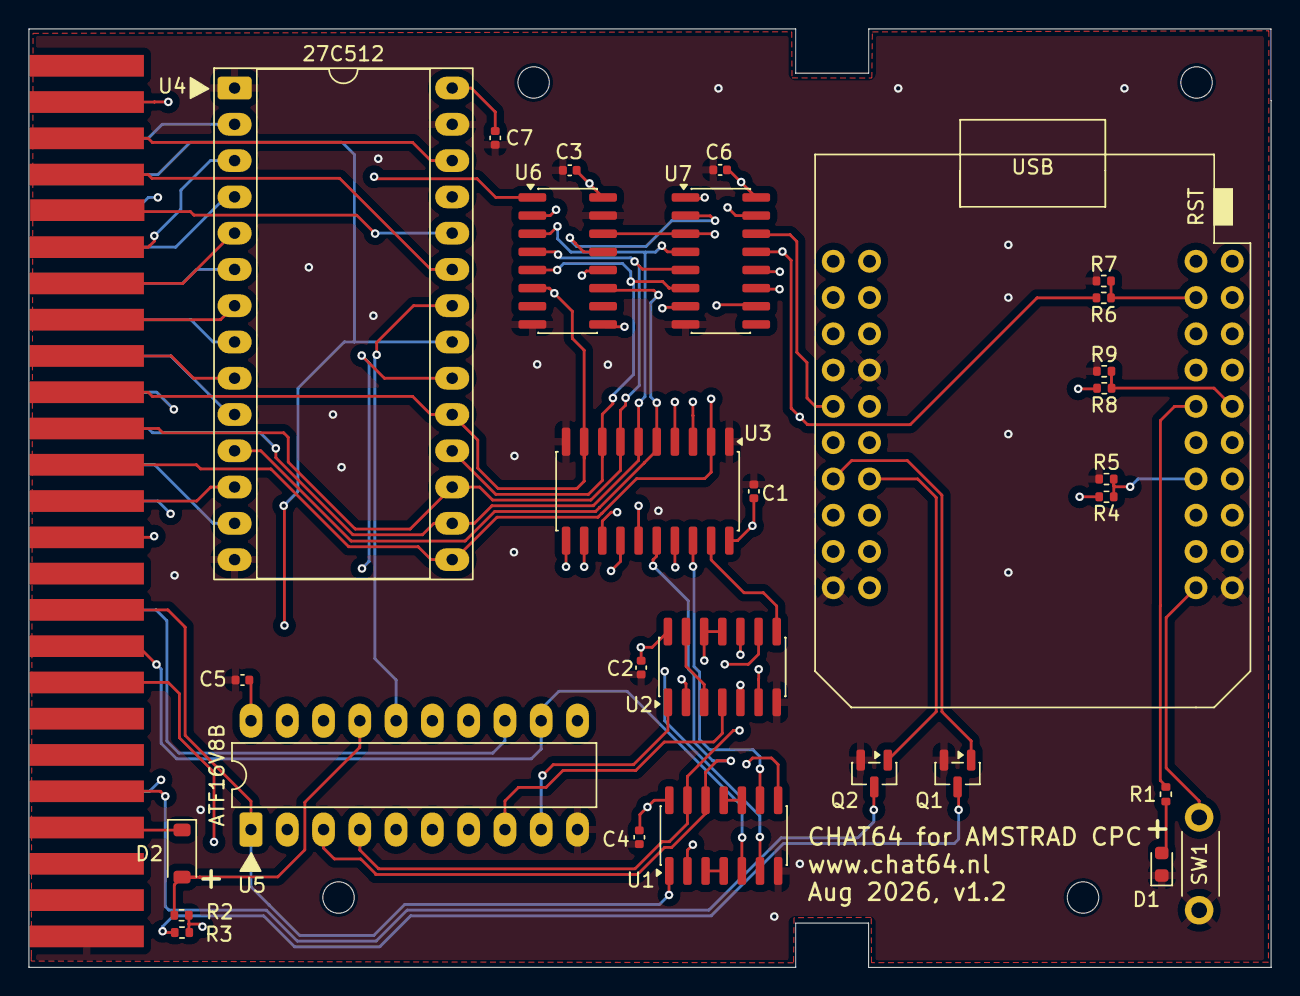
[picture p35: board cpc_Chat64_v1.1.kicad_pcb from above]

Board: 4 copper layers, 87.0 x 65.7 mm, 34 parts (0 on the bottom side), 65 nets.
