bvenneker/Chat64/MSX/KiCAD/msx_chat64.kicad_pcb

## KiCad design MSX/KiCAD/msx_chat64.kicad_pcb (2026-09-07)

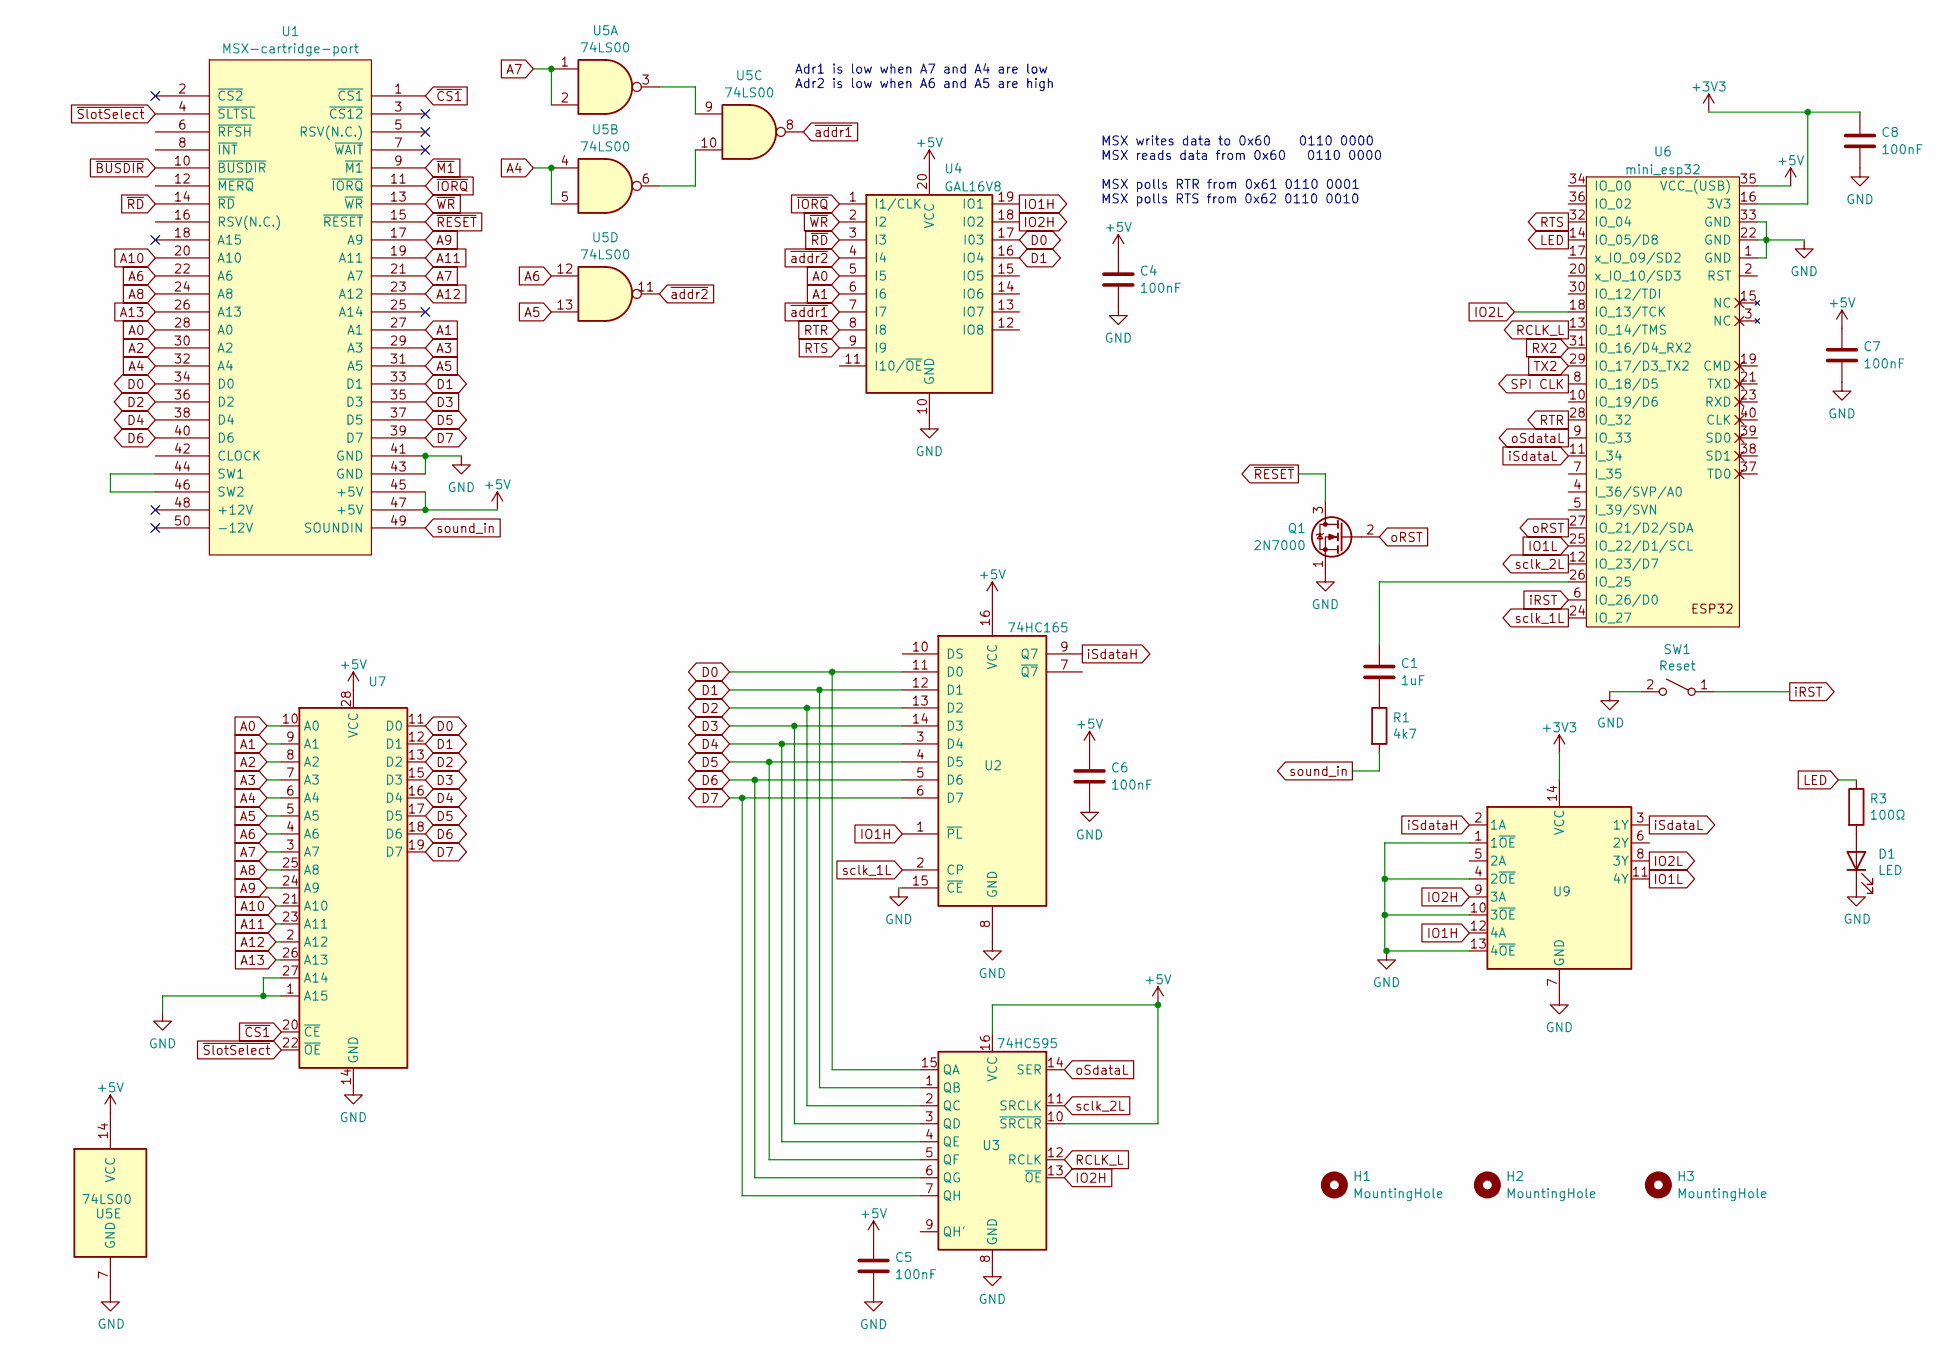
[picture p36: schematic msx_chat64.kicad_sch]

Parts:
C1: 1uF; C_Disc_D6.0mm_W2.5mm_P5.00mm
C4, C5, C6, C7, C8: 100nF; C_Disc_D6.0mm_W2.5mm_P5.00mm
D1: LED; LED_D3.0mm
H1, H2, H3: MountingHole; MountingHole_2.2mm_M2
Q1: 2N7000; TO-92_Inline
R1: 4k7; R_Axial_DIN0204_L3.6mm_D1.6mm_P5.08mm_Horizontal
R3: 100Ω; R_Axial_DIN0204_L3.6mm_D1.6mm_P5.08mm_Horizontal
SW1: Reset; SW_PUSH_HALF_6mm
U1: MSX-cartridge-port; MSX-Cart-NoSilkS
U2: 74HC165; DIP-16_W7.62mm_Socket_LongPads
U3: 74HC595; DIP-16_W7.62mm_Socket_LongPads
U4: GAL16V8; DIP-20_W7.62mm_Socket_LongPads
U5: 74LS00; DIP-14_W7.62mm_Socket_LongPads
U6: mini_esp32; ESP32_mini
U7: 27C512; DIP-28_W15.24mm_Socket_LongPads
U9: 74HCT125; DIP-14_W7.62mm_Socket_LongPads

Connections:
+3V3: C8.1, U6.16 (3V3), U9.14 (VCC)
+5V: C4.1, C5.1, C6.1, C7.1, U1.45 (+5V), U1.47 (+5V), U2.16 (VCC), U3.10 (~SRCLR), U3.16 (VCC), U4.20 (VCC), U5.14 (VCC), U6.35 (VCC_(USB)), U7.28 (VCC)
A0: U1.28 (A0), U4.5 (I5), U7.10 (A0)
A1: U1.27 (A1), U4.6 (I6), U7.9 (A1)
A2: U1.30 (A2), U7.8 (A2)
A3: U1.29 (A3), U7.7 (A3)
A4: U1.32 (A4), U5.4, U5.5, U7.6 (A4)
A5: U1.31 (A5), U5.13, U7.5 (A5)
A6: U1.22 (A6), U5.12, U7.4 (A6)
A7: U1.21 (A7), U5.1, U5.2, U7.3 (A7)
A8: U1.24 (A8), U7.25 (A8)
A9: U1.17 (A9), U7.24 (A9)
A10: U1.20 (A10), U7.21 (A10)
A11: U1.19 (A11), U7.23 (A11)
A12: U1.23 (A12), U7.2 (A12)
A13: U1.26 (A13), U7.26 (A13)
D0: U1.34 (D0), U2.11 (D0), U3.15 (QA), U4.17 (I03), U7.11 (D0)
D1: U1.33 (D1), U2.12 (D1), U3.1 (QB), U4.16 (IO4), U7.12 (D1)
D2: U1.36 (D2), U2.13 (D2), U3.2 (QC), U7.13 (D2)
D3: U1.35 (D3), U2.14 (D3), U3.3 (QD), U7.15 (D3)
D4: U1.38 (D4), U2.3 (D4), U3.4 (QE), U7.16 (D4)
D5: U1.37 (D5), U2.4 (D5), U3.5 (QF), U7.17 (D5)
D6: U1.40 (D6), U2.5 (D6), U3.6 (QG), U7.18 (D6)
D7: U1.39 (D7), U2.6 (D7), U3.7 (QH), U7.19 (D7)
GND: C4.2, C5.2, C6.2, C7.2, C8.2, D1.1 (K), Q1.1 (S), SW1.2 (B), U1.41 (GND), U1.43 (GND), U2.8 (GND), U2.15 (~CE), U3.8 (GND), U4.10 (GND), U5.7 (GND), U6.1 (GND), U6.22 (GND), U6.33 (GND), U7.1 (A15), U7.14 (GND), U7.27 (A14), U9.1 (1~OE), U9.4 (2~OE), U9.7 (GND), U9.10 (3~OE), U9.13 (4~OE)
IO1H: U2.1 (~PL), U4.19 (IO1), U9.12 (4A)
IO1L: U6.25 (IO_22/D1/SCL), U9.11 (4Y)
IO2H: U3.13 (~OE), U4.18 (IO2), U9.9 (3A)
IO2L: U6.18 (IO_13/TCK), U9.8 (3Y)
LED: R3.1, U6.14 (IO_05/D8)
unnamed: C1.2, R1.1
unnamed: D1.2 (A), R3.2
unnamed: U1.44 (SW1), U1.46 (SW2)
unnamed: U5.3, U5.9
unnamed: U5.6, U5.10
unnamed: C1.1, U6.26 (IO_25)
RCLK_L: U3.12 (RCLK), U6.13 (IO_14/TMS)
RTR: U4.8 (I8), U6.28 (IO_32)
RTS: U4.9 (I9), U6.32 (IO_04)
RX2: U6.31 (IO_16/D4_RX2)
SPI CLK: U6.8 (IO_18/D5)
TX2: U6.29 (IO_17/D3_TX2)
iRST: SW1.1 (A), U6.6 (IO_26/D0)
iSdataH: U2.9 (Q7), U9.2 (1A)
iSdataL: U6.11 (I_34), U9.3 (1Y)
oRST: Q1.2 (G), U6.27 (IO_21/D2/SDA)
oSdataL: U3.14 (SER), U6.9 (IO_33)
sclk_1L: U2.2 (CP), U6.24 (IO_27)
sclk_2L: U3.11 (SRCLK), U6.12 (IO_23/D7)
sound_in: R1.2, U1.49 (SOUNDIN)
~BUSDIR: U1.10 (~BUSDIR)
~CS1: U1.1 (~CS1), U7.20 (~CE)
~IORQ: U1.11 (~IORQ), U4.1 (I1/CLK)
~M1: U1.9 (~M1)
~RD: U1.14 (~RD), U4.3 (I3)
~RESET: Q1.3 (D), U1.15 (~RESET)
~SlotSelect: U1.4 (~SLTSL), U7.22 (~OE)
~WR: U1.13 (~WR), U4.2 (I2)
~addr1: U4.7 (I7), U5.8
~addr2: U4.4 (I4), U5.11

Notes on the sheet:
Adr1 is low when A7 and A4 are low Adr2 is low when A6 and A5 are high
MSX writes data to 0x60 0110 0000 MSX reads data from 0x60 0110 0000 MSX polls RTR from 0x61 0110 0001 MSX polls RTS from 0x62 0110 0010

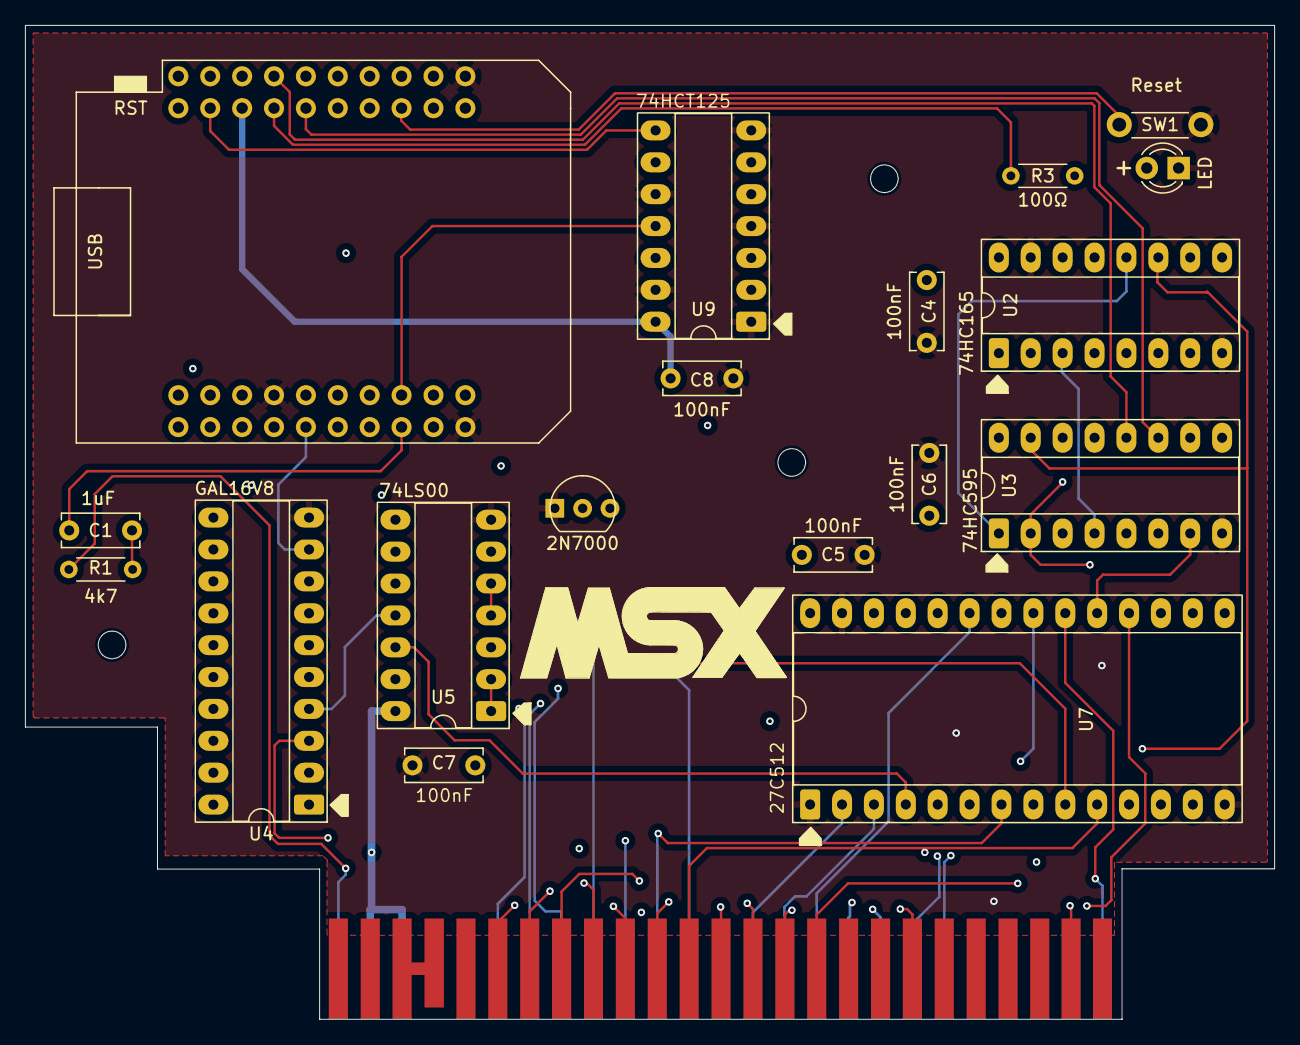
[picture p37: board msx_chat64.kicad_pcb from above]

Board: 4 copper layers, 99.5 x 79.2 mm, 22 parts (0 on the bottom side), 55 nets.
