bvenneker/Chat64/Atari800XL/KiCAD/Cartridge_800xl_2.kicad_pcb

## KiCad design Atari800XL/KiCAD/Cartridge_800xl_2.kicad_pcb (2026-09-07)

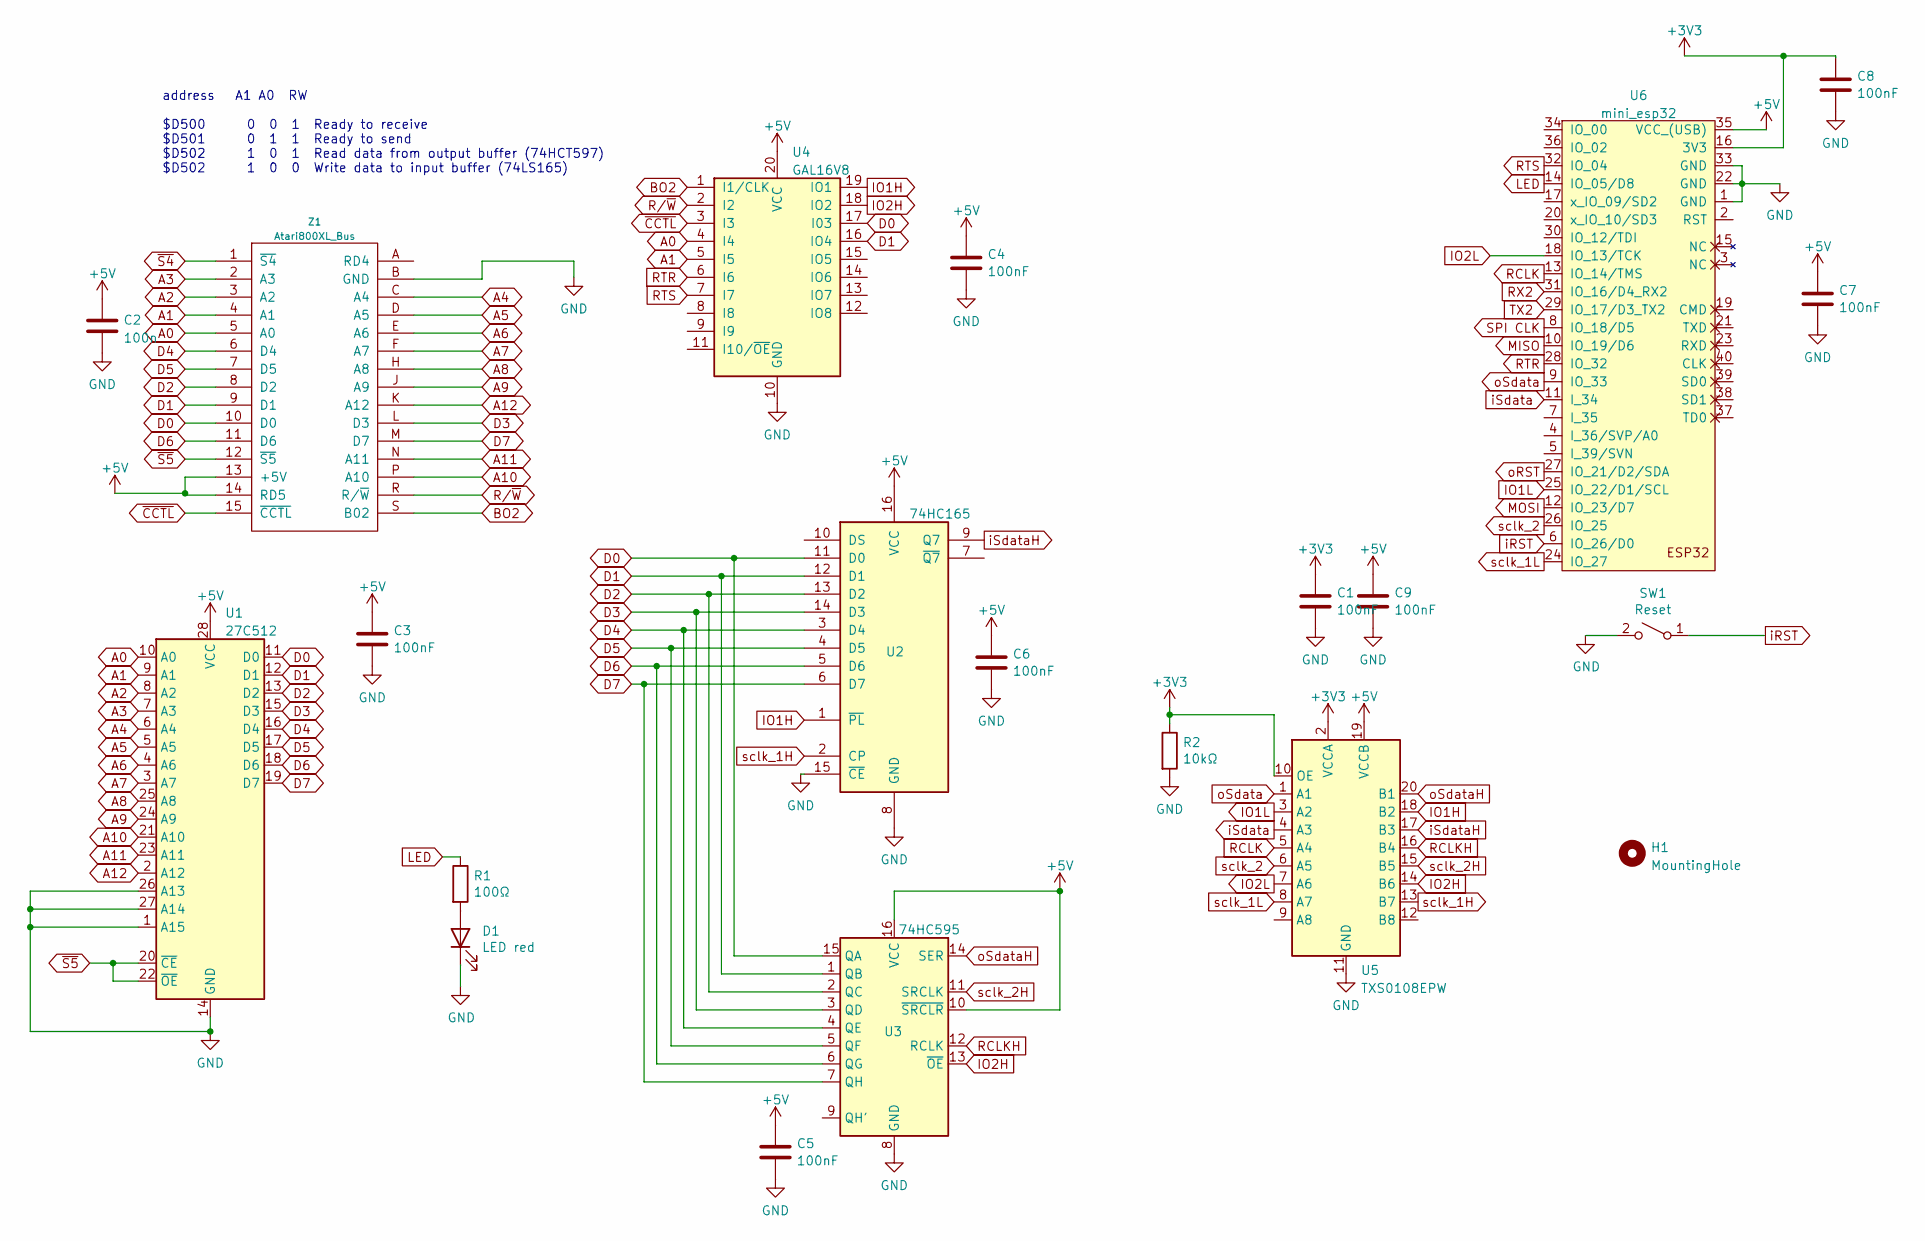
[picture p38: schematic Cartridge_800xl_2.kicad_sch]

Parts:
C1, C3, C4, C5, C6, C7, C8, C9: 100nF; C_0402_1005Metric
C2: 100n; C_0402_1005Metric
D1: LED red; LED_0603_1608Metric
H1: MountingHole; MountingHole_3.2mm_M3
R1: 100Ω; R_0402_1005Metric
R2: 10kΩ; R_0402_1005Metric
SW1: Reset; SW_PUSH_HALF_6mm
U1: 27C512; DIP-28_W15.24mm_LongPads
U2: 74HC165; SOIC-16_3.9x9.9mm_P1.27mm
U3: 74HC595; SOIC-16_3.9x9.9mm_P1.27mm
U4: GAL16V8; DIP-20_W7.62mm_LongPads
U5: TXS0108EPW; TSSOP-20_4.4x6.5mm_P0.65mm
U6: mini_esp32; ESP32_mini
Z1: Atari800XL_Bus; Atari_bus

Connections:
+3V3: C1.1, C8.1, R2.1, U5.2 (VCCA), U5.10 (OE), U6.16 (3V3)
+5V: C2.1, C3.1, C4.1, C5.1, C6.1, C7.1, C9.1, U1.28 (VCC), U2.16 (VCC), U3.10 (~SRCLR), U3.16 (VCC), U4.20 (VCC), U5.19 (VCCB), U6.35 (VCC_(USB)), Z1.13 (+5V), Z1.14 (RD5)
A0: U1.10 (A0), U4.4 (I4), Z1.5 (A0)
A1: U1.9 (A1), U4.5 (I5), Z1.4 (A1)
A2: U1.8 (A2), Z1.3 (A2)
A3: U1.7 (A3), Z1.2 (A3)
A4: U1.6 (A4), Z1.C (A4)
A5: U1.5 (A5), Z1.D (A5)
A6: U1.4 (A6), Z1.E (A6)
A7: U1.3 (A7), Z1.F (A7)
A8: U1.25 (A8), Z1.H (A8)
A9: U1.24 (A9), Z1.J (A9)
A10: U1.21 (A10), Z1.P (A10)
A11: U1.23 (A11), Z1.N (A11)
A12: U1.2 (A12), Z1.K (A12)
BO2: U4.1 (I1/CLK), Z1.S (B02)
D0: U1.11 (D0), U2.11 (D0), U3.15 (QA), U4.17 (I03), Z1.10 (D0)
D1: U1.12 (D1), U2.12 (D1), U3.1 (QB), U4.16 (IO4), Z1.9 (D1)
D2: U1.13 (D2), U2.13 (D2), U3.2 (QC), Z1.8 (D2)
D3: U1.15 (D3), U2.14 (D3), U3.3 (QD), Z1.L (D3)
D4: U1.16 (D4), U2.3 (D4), U3.4 (QE), Z1.6 (D4)
D5: U1.17 (D5), U2.4 (D5), U3.5 (QF), Z1.7 (D5)
D6: U1.18 (D6), U2.5 (D6), U3.6 (QG), Z1.11 (D6)
D7: U1.19 (D7), U2.6 (D7), U3.7 (QH), Z1.M (D7)
GND: C1.2, C2.2, C3.2, C4.2, C5.2, C6.2, C7.2, C8.2, C9.2, D1.1 (K), R2.2, SW1.2 (B), U1.1 (A15), U1.14 (GND), U1.26 (A13), U1.27 (A14), U2.8 (GND), U2.15 (~CE), U3.8 (GND), U4.10 (GND), U5.11 (GND), U6.1 (GND), U6.22 (GND), U6.33 (GND), Z1.B (GND)
IO1H: U2.1 (~PL), U4.19 (IO1), U5.18 (B2)
IO1L: U5.3 (A2), U6.25 (IO_22/D1/SCL)
IO2H: U3.13 (~OE), U4.18 (IO2), U5.14 (B6)
IO2L: U5.7 (A6), U6.18 (IO_13/TCK)
LED: R1.1, U6.14 (IO_05/D8)
MISO: U6.10 (IO_19/D6)
MOSI: U6.12 (IO_23/D7)
unnamed: D1.2 (A), R1.2
RCLK: U5.5 (A4), U6.13 (IO_14/TMS)
RCLKH: U3.12 (RCLK), U5.16 (B4)
RTR: U4.6 (I6), U6.28 (IO_32)
RTS: U4.7 (I7), U6.32 (IO_04)
RX2: U6.31 (IO_16/D4_RX2)
R/~W: U4.2 (I2), Z1.R (R/~W)
SPI CLK: U6.8 (IO_18/D5)
TX2: U6.29 (IO_17/D3_TX2)
iRST: SW1.1 (A), U6.6 (IO_26/D0)
iSdata: U5.4 (A3), U6.11 (I_34)
iSdataH: U2.9 (Q7), U5.17 (B3)
oRST: U6.27 (IO_21/D2/SDA)
oSdata: U5.1 (A1), U6.9 (IO_33)
oSdataH: U3.14 (SER), U5.20 (B1)
sclk_1H: U2.2 (CP), U5.13 (B7)
sclk_1L: U5.8 (A7), U6.24 (IO_27)
sclk_2: U5.6 (A5), U6.26 (IO_25)
sclk_2H: U3.11 (SRCLK), U5.15 (B5)
~CCTL: U4.3 (I3), Z1.15 (~CCTL)
~S4: Z1.1 (~S4)
~S5: U1.20 (~CE), U1.22 (~OE), Z1.12 (~S5)

Notes on the sheet:
address A1 A0 RW $D500 0 0 1 Ready to receive $D501 0 1 1 Ready to send $D502 1 0 1 Read data from output buffer (74HCT597) $D502 1 0 0 Write data to input buffer (74LS165)

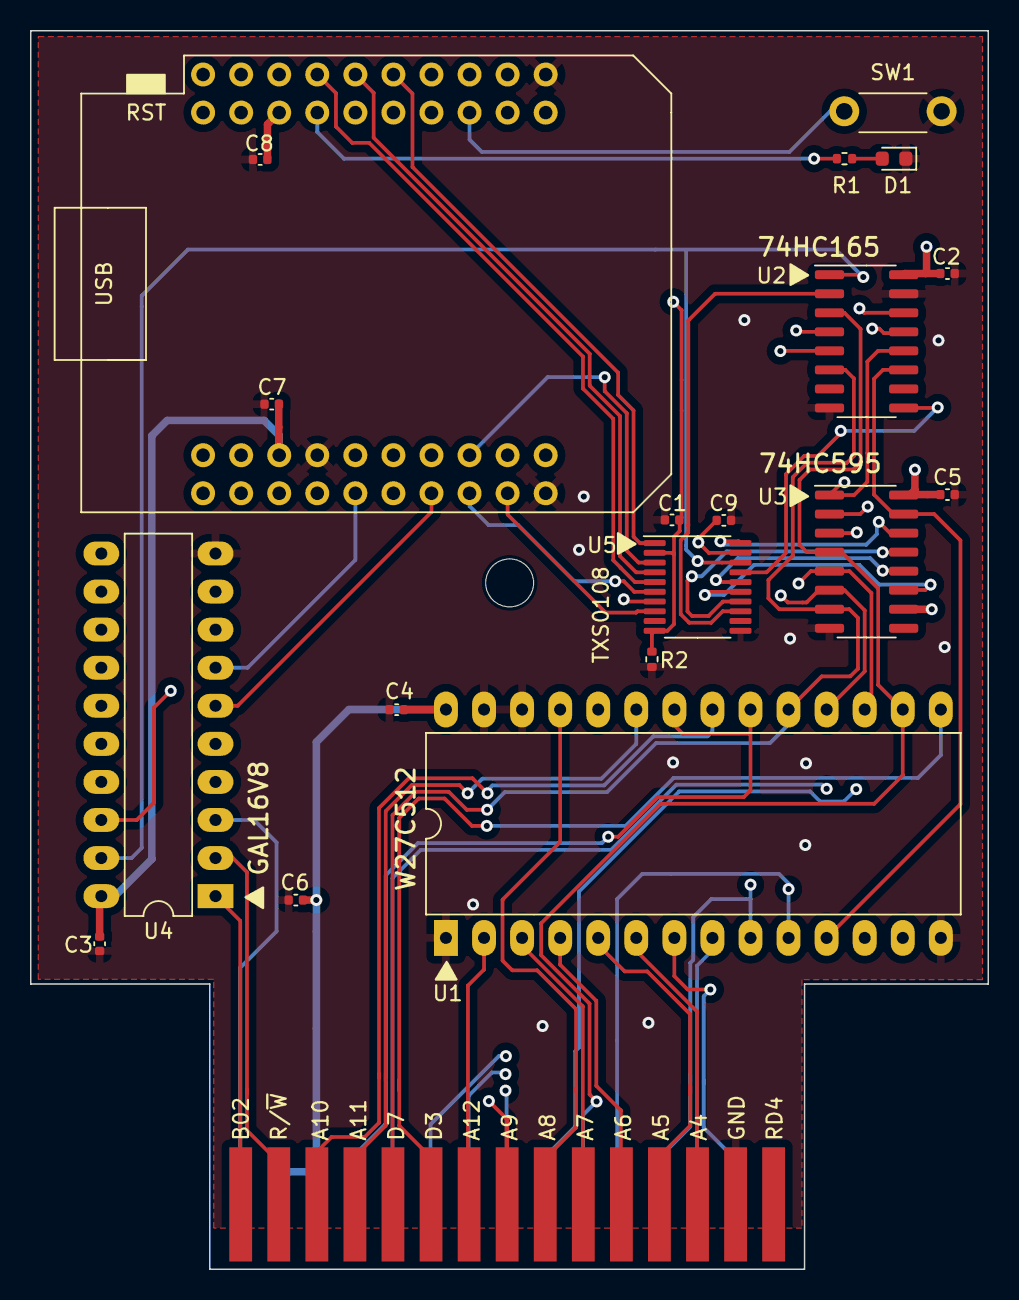
[picture p39: board Cartridge_800xl_2.kicad_pcb from above]

Board: 4 copper layers, 63.9 x 82.6 mm, 21 parts (0 on the bottom side), 47 nets.
