bvenneker/Chat64/Commodore/KiCAD/Dev cartridge/Chat_2024_rev_3.9_DEV/ESP32Hardware.kicad_pcb

## KiCad design Commodore/KiCAD/Dev cartridge/Chat_2024_rev_3.9_DEV/ESP32Hardware.kicad_pcb (2026-09-05)

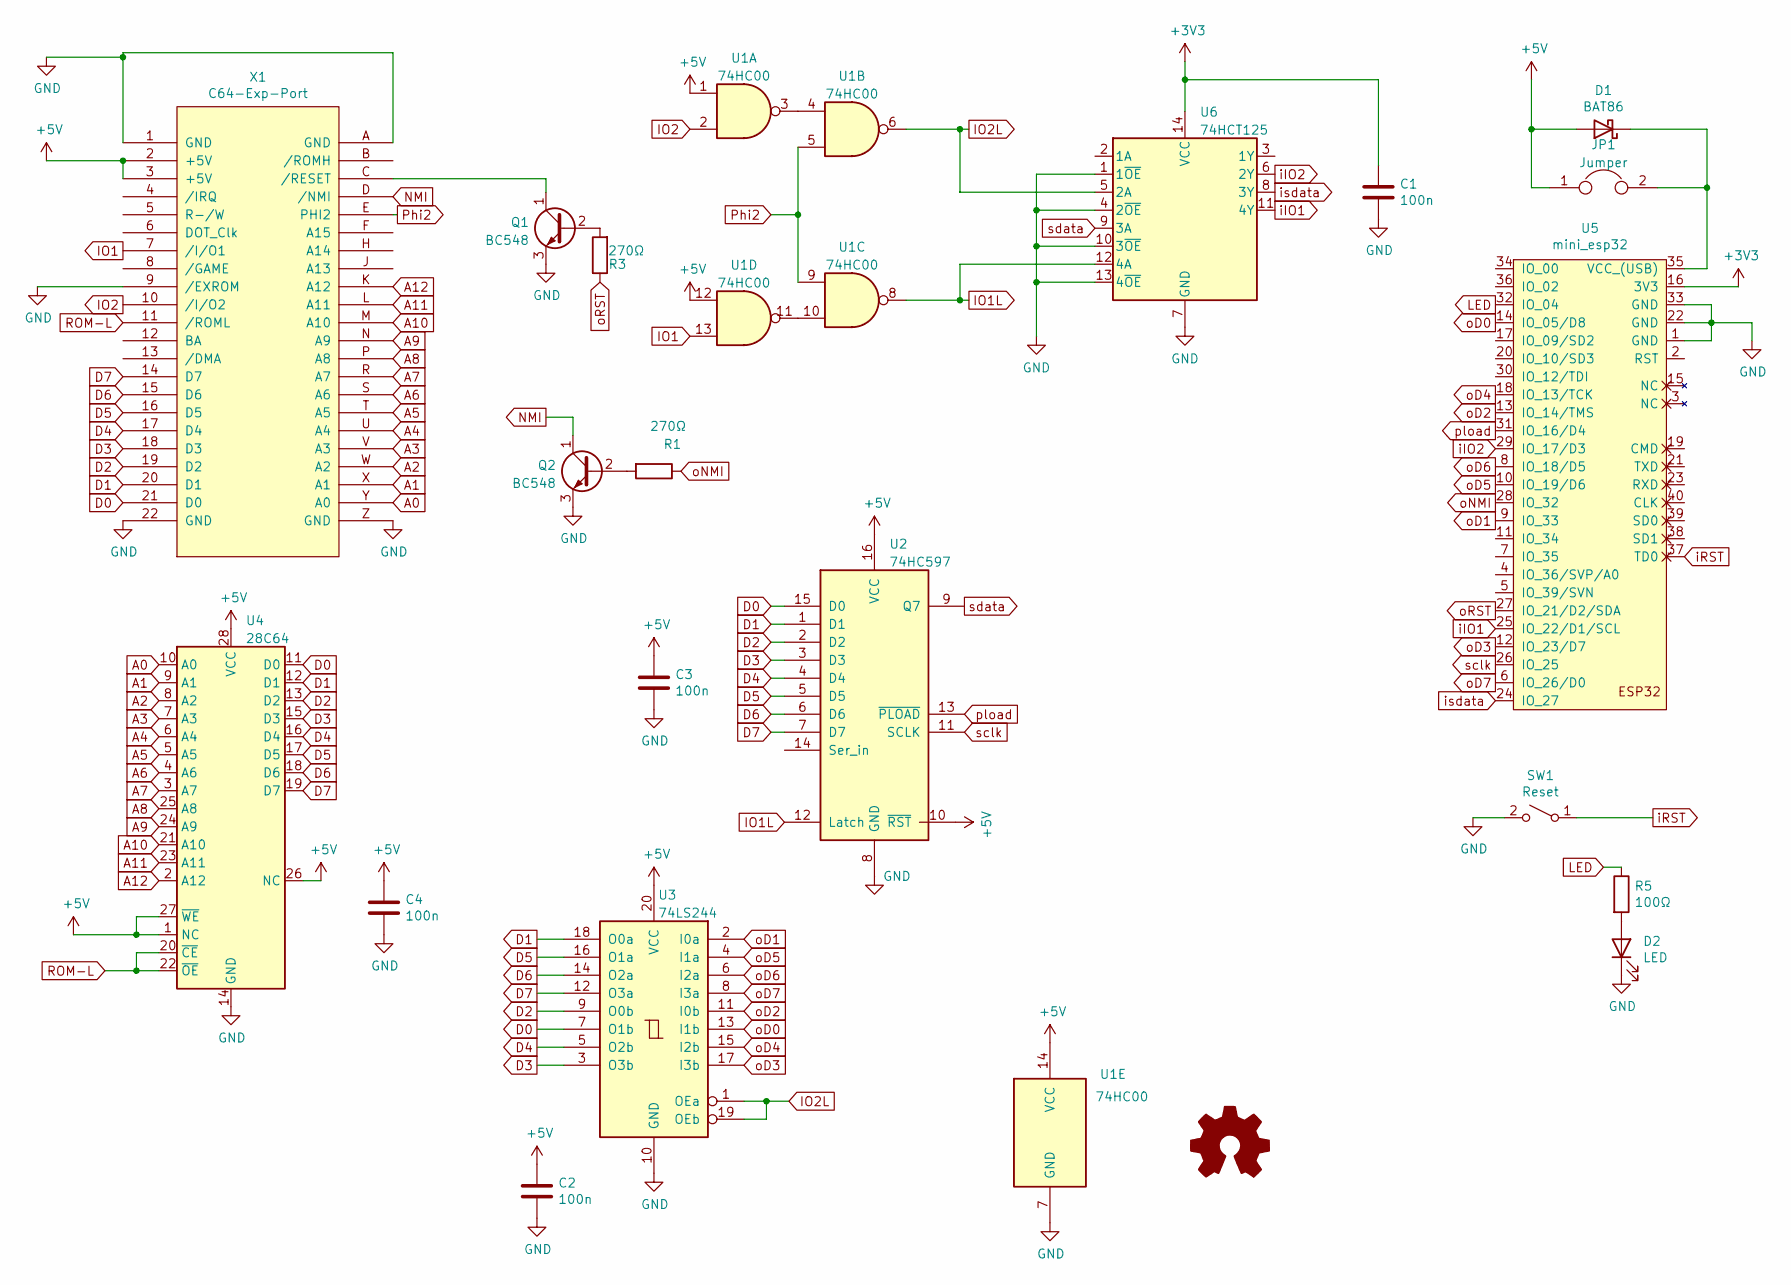
[picture p40: schematic ESP32Hardware.kicad_sch]

Parts:
C1, C2, C3, C4: 100n; C_Disc_D4.3mm_W1.9mm_P5.00mm
D1: BAT86; D_DO-34_SOD68_P7.62mm_Horizontal
D2: LED; LED_D3.0mm
JP1: Jumper; PinHeader_1x02_P2.54mm_Vertical
LOGO1: Logo_Open_Hardware_Small; OSHW-Logo2_14.6x12mm_SilkScreen
Q1, Q2: BC548; TO-92_Inline
R1, R3: 270Ω; R_Axial_DIN0204_L3.6mm_D1.6mm_P5.08mm_Horizontal
R5: 100Ω; R_Axial_DIN0204_L3.6mm_D1.6mm_P5.08mm_Horizontal
SW1: Reset; SW_PUSH_6mm
U1: 74HC00; DIP-14_W7.62mm_LongPads
U2: 74HC597; DIP-16_W7.62mm_LongPads
U3: 74LS244; DIP-20_W7.62mm_LongPads
U4: 28C64; 28ZIF600_2
U5: mini_esp32; ESP32_mini
U6: 74HCT125; DIP-14_W7.62mm_LongPads
X1: C64-Exp-Port; C64-Cart-NoSilkS

Connections:
+3V3: C1.1, U5.16 (3V3), U6.14 (VCC)
+5V: C2.1, C3.1, C4.1, D1.2 (A), JP1.1, U1.1, U1.12, U1.14 (VCC), U2.10 (~RST), U2.16 (VCC), U3.20 (VCC), U4.1 (NC), U4.26 (NC), U4.27 (~WE), U4.28 (VCC), X1.2 (+5V), X1.3 (+5V)
A0: U4.10 (A0), X1.Y (A0)
A1: U4.9 (A1), X1.X (A1)
A2: U4.8 (A2), X1.W (A2)
A3: U4.7 (A3), X1.V (A3)
A4: U4.6 (A4), X1.U (A4)
A5: U4.5 (A5), X1.T (A5)
A6: U4.4 (A6), X1.S (A6)
A7: U4.3 (A7), X1.R (A7)
A8: U4.25 (A8), X1.P (A8)
A9: U4.24 (A9), X1.N (A9)
A10: U4.21 (A10), X1.M (A10)
A11: U4.23 (A11), X1.L (A11)
A12: U4.2 (A12), X1.K (A12)
D0: U2.15 (D0), U3.7 (O1b), U4.11 (D0), X1.21 (D0)
D1: U2.1 (D1), U3.18 (O0a), U4.12 (D1), X1.20 (D1)
D2: U2.2 (D2), U3.9 (O0b), U4.13 (D2), X1.19 (D2)
D3: U2.3 (D3), U3.3 (O3b), U4.15 (D3), X1.18 (D3)
D4: U2.4 (D4), U3.5 (O2b), U4.16 (D4), X1.17 (D4)
D5: U2.5 (D5), U3.16 (O1a), U4.17 (D5), X1.16 (D5)
D6: U2.6 (D6), U3.14 (O2a), U4.18 (D6), X1.15 (D6)
D7: U2.7 (D7), U3.12 (O3a), U4.19 (D7), X1.14 (D7)
GND: C1.2, C2.2, C3.2, C4.2, D2.1 (K), Q1.3 (E), Q2.3 (E), SW1.2 (B), U1.7 (GND), U2.8 (GND), U3.10 (GND), U4.14 (GND), U5.1 (GND), U5.22 (GND), U5.33 (GND), U6.1 (1~OE), U6.4 (2~OE), U6.7 (GND), U6.10 (3~OE), U6.13 (4~OE), X1.1 (GND), X1.9 (/EXROM), X1.22 (GND), X1.A (GND), X1.Z (GND)
IO1: U1.13, X1.7 (/I/O1)
IO1L: U1.8, U2.12 (Latch), U6.12 (4A)
IO2: U1.2, X1.10 (/I/O2)
IO2L: U1.6, U3.1 (OEa), U3.19 (OEb), U6.5 (2A)
LED: R5.1, U5.32 (IO_04)
NMI: Q2.1 (C), X1.D (/NMI)
unnamed: D1.1 (K), JP1.2, U5.35 (VCC_(USB))
unnamed: D2.2 (A), R5.2
unnamed: Q1.1 (C), X1.C (/RESET)
unnamed: Q1.2 (B), R3.2
unnamed: Q2.2 (B), R1.2
unnamed: U1.3, U1.4
unnamed: U1.10, U1.11
Phi2: U1.5, U1.9, X1.E (PHI2)
ROM-L: U4.20 (~CE), U4.22 (~OE), X1.11 (/ROML)
iIO1: U5.25 (IO_22/D1/SCL), U6.11 (4Y)
iIO2: U5.29 (IO_17/D3), U6.6 (2Y)
iRST: SW1.1 (A), U5.37 (TD0)
isdata: U5.24 (IO_27), U6.8 (3Y)
oD0: U3.13 (I1b), U5.14 (IO_05/D8)
oD1: U3.2 (I0a), U5.9 (IO_33)
oD2: U3.11 (I0b), U5.13 (IO_14/TMS)
oD3: U3.17 (I3b), U5.12 (IO_23/D7)
oD4: U3.15 (I2b), U5.18 (IO_13/TCK)
oD5: U3.4 (I1a), U5.10 (IO_19/D6)
oD6: U3.6 (I2a), U5.8 (IO_18/D5)
oD7: U3.8 (I3a), U5.6 (IO_26/D0)
oNMI: R1.1, U5.28 (IO_32)
oRST: R3.1, U5.27 (IO_21/D2/SDA)
pload: U2.13 (~PLOAD), U5.31 (IO_16/D4)
sclk: U2.11 (SCLK), U5.26 (IO_25)
sdata: U2.9 (Q7), U6.9 (3A)

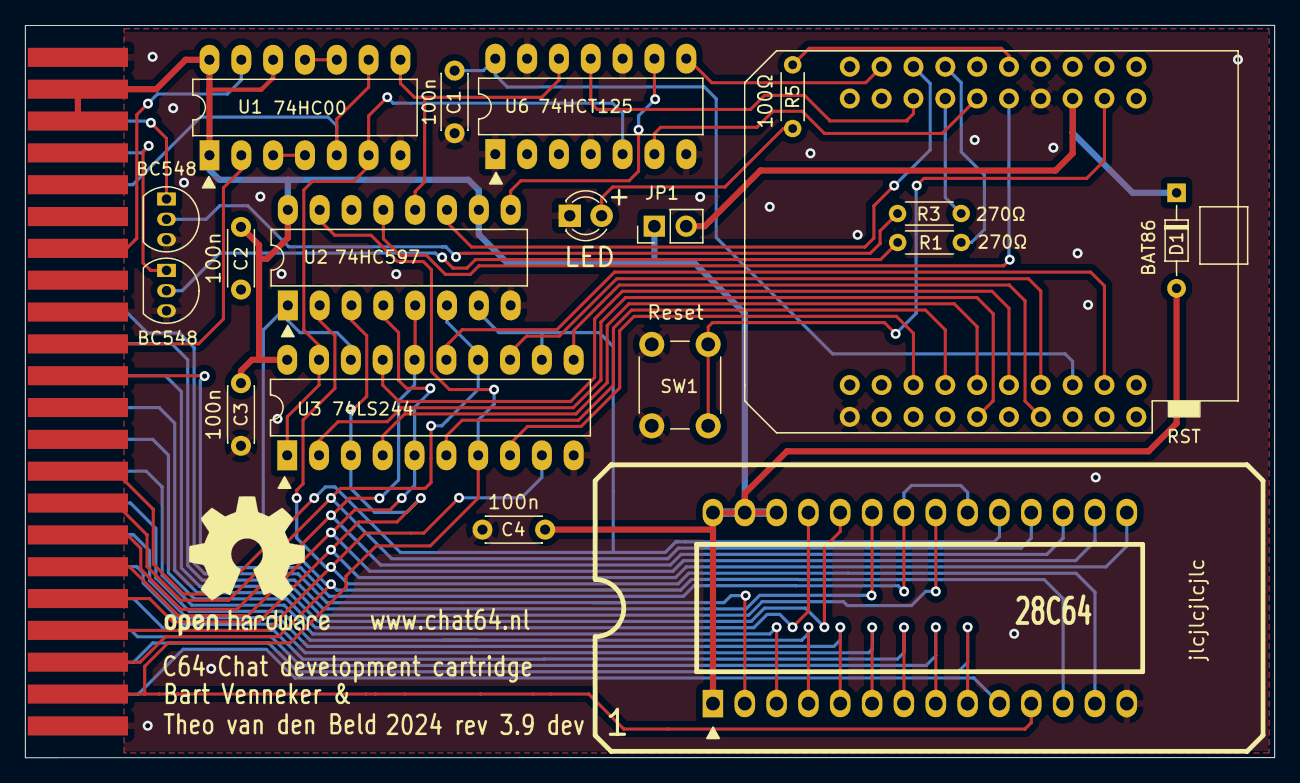
[picture p41: board ESP32Hardware.kicad_pcb from above]

Board: 2 copper layers, 99.7 x 58.4 mm, 21 parts (0 on the bottom side), 56 nets.
