bvenneker/Chat64/(commit log)

2026-09-06 Commodore Update
    [Cartridge knobs.3mf, Chat64 SMD cartridge.3mf, ESP32Hardware.kicad_pcb, ESP32Hardware.kicad_sch, Smd-knob.stl, Smd-knob_short.stl, Smd-lower.stl, Smd-upper.stl]
2026-09-06 Spectrum pcb
    [Cartridge knobs.3mf, Chat64 SMD cartridge.3mf, SMD_Button.stl, SMD_Shell_Bottom.stl, SMD_Shell_Top.stl, Smd-knob.stl, Smd-knob_short.stl, Smd-lower.stl]
2026-09-07 new setup
    [Atari_Chat_Cartridge_Bottom.stl, Atari_Chat_Cartridge_Button.stl, Atari_Chat_Cartridge_Top.stl, Cartridge_800xl_2.kicad_pcb, Cartridge_800xl_2.kicad_sch, MSX Cartridge_Bottom.stl, MSX Cartridge_Button.stl, MSX Cartridge_Top.stl]
